TUDA-MUST/Multi-Ferro-DAQ/Blink/README.txt

This is a first example programm to test the programming of
the Schlaubi-Schlumpf board.
It intends to use the LEDs in a simple manner

It may be useful to label the boot and reset button on future iterations:
S2 -> booot -> inner button
S3 -> reset -> outer button

Blink is deprecated due to timing, Blink2 is the current version
