TUDA-MUST/Multi-Ferro-DAQ/Software/ADC_readout/deprecated/notes.txt

bbb131E08: 
	ist für BeagleBone PRU in ARM Assembly geschrieben -> ungeeignet
ads131e08:
	ist für stm32 in c geschrieben, muss auf andere HW umgeschrieben werden
