TUDA-MUST/Multi-Ferro-DAQ/Migration_from_MATLAB/C_GUI_Host/hqdefault-2535131512.jpg

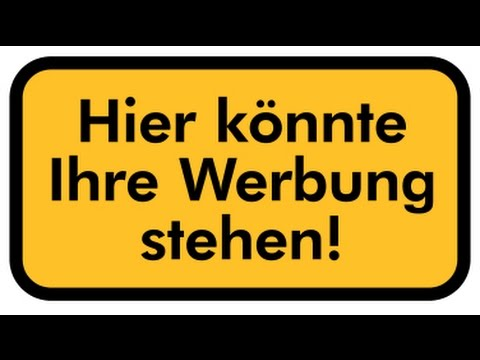
Migration_from_MATLAB/C_GUI_Host/hqdefault-2535131512.jpg
