TUDA-MUST/Multi-Ferro-DAQ/PCB/Schlaubi-Schlumpf/aay7rrjnp.png

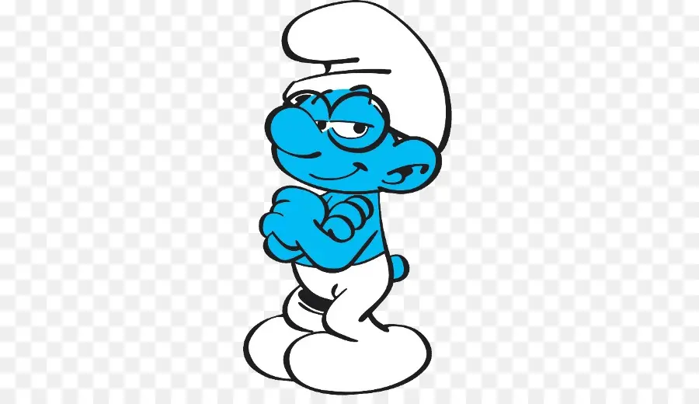
PCB/Schlaubi-Schlumpf/aay7rrjnp.png
