TUDA-MUST/Multi-Ferro-DAQ/PCB/BOM/BOM_Multi-Ferro-DAQ_v1.3.csv

Item | Qty | Designators | Value | Category | Manufacturer | MPN | Package | Specs | LCSC | Footprint | Datasheet | Notes
1 | 1 | IC1 | ADS131E08IPAGR | IC | Texas Instruments | ADS131E08IPAGR | TQFP-64 | 8-ch, 24-bit simultaneous-sampling ΔΣ ADC, up to 64 kSPS, SPI | C190276 | QFP50P1200X1200X120-64N | https://www.lcsc.com/datasheet/C190276.pdf
2 | 1 | IC2 | TP4056 | IC | TOP POWER ASIC | TP4056X-42-ESOP8 | ESOP-8 | 1-cell Li-ion linear charger, 4.2 V, ≤1 A | C2763448 | SOP127P600X175-9N | https://www.lcsc.com/datasheet/C2763448.pdf | No cell protection on board – use a protected 1S Li-ion/LiPo cell.
3 | 1 | IC3 | TLV9051IDBVR | IC | Texas Instruments | TLV9051IDBVR | SOT-23-5 | RRIO op-amp, 5 MHz, 1.8–6 V | C1849429 | SOT95P280X145-5N | https://www.lcsc.com/datasheet/C1849429.pdf | V_bias buffer
4 | 1 | IC5 | TPS7A9101DSKR | IC | Texas Instruments | TPS7A9101DSKR | WSON-10 2.5×2.5 | 1 A adjustable low-noise LDO, 4.7 µV_RMS | C2878140 | SON50P250X250X80-11N-D | https://www.lcsc.com/datasheet/C2878140.pdf
5 | 1 | IC7 | LM2775QDSGRQ1 | IC | Texas Instruments | LM2775QDSGRQ1 | WSON-8 2×2 | Switched-cap boost, 5 V out, 200 mA | C2071153 | SON50P200X200X80-9N | https://www.lcsc.com/datasheet/C2071153.pdf
6 | 2 | U1, U4 | AD8608ARUZ-REEL | IC | Analog Devices | AD8608ARUZ-REEL | TSSOP-14 | Quad CMOS RRIO op-amp, 2.7–5.5 V, 10 MHz GBW, 1 pA I_b, 75 µV V_os | C578777 | RU_14_ADI | https://www.lcsc.com/datasheet/C578777.pdf | Charge amplifiers, 2 × 4 channels
7 | 1 | U3 | ICM-42670-P | IC | TDK InvenSense | ICM-42670-P | LGA-14 2.5×3 mm | 6-axis IMU, I²C/SPI/I3C | C3288646 | LGA14_2.5X3X0.76_IVS | https://www.lcsc.com/datasheet/C3288646.pdf | Populated but not used by current firmware
8 | 1 | U2 | ESP32-S3-MINI-1-N8 | Module | Espressif | ESP32-S3-MINI-1-N8 | SMD module | ESP32-S3, 8 MB flash, Wi-Fi/BLE 5, PCB antenna | C2913206 | XCVR_ESP32-S3-MINI-1-N8 | https://www.lcsc.com/datasheet/C2913206.pdf
9 | 1 | Q1 | DMG2305 | Transistor | TECH PUBLIC | DMG2305UX | SOT-23 | P-MOSFET, −20 V, 4.1 A, 52 mΩ @ 4.5 V | C2940629 | DMG2305UX | https://www.lcsc.com/datasheet/C2940629.pdf | LCSC part is a second-source of the Diodes Inc. DMG2305UX
10 | 1 | D1 | D_Schottky | Diode | R+O | BAT60B | SOD-323 | Schottky, 10 V, 3 A, 0.6 V @ 1 A | C7502695 | D_SOD-323 | https://www.lcsc.com/datasheet/C7502695.pdf
11 | 1 | U5 | WE-TVS-82400102 | Diode | Würth Elektronik | 82400102 | SOT-23-6 | 2-ch low-capacitance TVS array (WE-TVS), USB | C1975330 | SOT-23-6 | https://uk.farnell.com/wurth-elektronik/82400102/diode-tvs-2-ch-esd-usb1-2-s0t23/dp/1825875 | USB ESD protection
12 | 2 | D2, D3 | LED_R | LED | Hubei KENTO | KT-0603R | 0603 | Red, 615–630 nm | C2286 | LED_0603_1608Metric | https://www.lcsc.com/datasheet/C2286.pdf
13 | 1 | D4 | LED_W | LED | Hubei KENTO | KT-0603W | 0603 | White | C2290 | LED_0603_1608Metric | https://www.lcsc.com/datasheet/C2290.pdf | Under RF shield, flashes when ADC is configured
14 | 2 | D5, D6 | SK6812MINI-HS | LED | OPSCO | SK6812MINI-HS | 3.5×3.5 mm | Addressable RGB LED, 5 V | C2922787 | SK6812MNI-HS | https://www.lcsc.com/datasheet/C2922787.pdf | Status LEDs
15 | 7 | R1, R12, R13, R15, R16, R17, R2 | 10k | Resistor | UNI-ROYAL | 0603WAF1002T5E | 0603 | 10 kΩ ±1 %, 100 mW, thick film | C25804 | R_0603_1608Metric | https://www.lcsc.com/datasheet/C25804.pdf
16 | 2 | R19, R20 | 5.1k | Resistor | UNI-ROYAL | 0603WAF5101T5E | 0603 | 5.1 kΩ ±1 %, 100 mW, thick film | C23186 | R_0603_1608Metric | https://www.lcsc.com/datasheet/C23186.pdf | USB-C CC pull-downs
17 | 1 | R27 | 27R | Resistor | UNI-ROYAL | 0603WAF270JT5E | 0603 | 27 Ω ±1 %, 100 mW, thick film | C25190 | R_0603_1608Metric | https://www.lcsc.com/datasheet/C25190.pdf
18 | 4 | R28, R29, R30, Rf_Op1 | 0R | Resistor | UNI-ROYAL | 0603WAF0000T5E | 0603 | 0 Ω jumper, 100 mW | C21189 | R_0603_1608Metric | https://www.lcsc.com/datasheet/C21189.pdf
19 | 3 | R3, R4, R5 | 100R | Resistor | UNI-ROYAL | 0603WAF1000T5E | 0603 | 100 Ω ±1 %, 100 mW, thick film | C22775 | R_0603_1608Metric | https://www.lcsc.com/datasheet/C22775.pdf
20 | 1 | R32 | 1.15k | Resistor | YAGEO | RT0603BRE071K15L | 0603 | 1.15 kΩ ±0.1 %, 100 mW, ±50 ppm/K, thin film | C861724 | R_0603_1608Metric | https://www.lcsc.com/datasheet/C861724.pdf | LDO feedback divider (bottom). DVDD = 0.8 V × (1 + R33/R32) ≈ 3.28 V. Keep 0.1 % thin film.
21 | 2 | R33, R7 | 3.57k | Resistor | YAGEO | RT0603BRE073K57L | 0603 | 3.57 kΩ ±0.1 %, 100 mW, ±50 ppm/K, thin film | C326745 | R_0603_1608Metric | https://www.lcsc.com/datasheet/C326745.pdf | R33: LDO feedback divider (top), keep 0.1 % thin film. R7: TP4056 PROG resistor, I_chg ≈ 1200 V / 3.57 kΩ ≈ 336 mA (any 1 % part is fine here).
22 | 1 | R6 | 1k | Resistor | UNI-ROYAL | 0603WAF1001T5E | 0603 | 1 kΩ ±1 %, 100 mW, thick film | C21190 | R_0603_1608Metric | https://www.lcsc.com/datasheet/C21190.pdf
23 | 8 | RF1, RF2, RF3, RF4, RF5, RF6, RF7, RF8 | 1G | Resistor | Stackpole (SEI) | HVCB0805KDL1G00 | 0805 | 1 GΩ ±10 %, 200 mW, 600 V, ±200 ppm/K, thick film | C2484710 | R_0805_2012Metric_Pad1.20x1.40mm_HandSolder | https://www.lcsc.com/datasheet/C2484710.pdf | CRITICAL – charge-amp feedback resistor R_F. Sets τ = R_F·C_F = 0.68 s and the low-frequency corner; ±10 % tolerance applies directly to τ. Hand-solder footprint.
24 | 16 | C1, C8, C9, CS11, CS16, CS18, CS2, CS31, CS34, CS39, CS40, CS41, CS42, CS50, CS52, CS9 | 10u | Capacitor | Samsung Electro-Mechanics | CL10A106KP8NNNC | 0603 | 10 µF ±10 %, 10 V, X5R | C19702 | C_0603_1608Metric | https://www.lcsc.com/datasheet/C19702.pdf
25 | 11 | CCH1, CS10, CS12, CS13, CS14, CS4, CS47, CS48, CS5, CS7, CS8 | 1u | Capacitor | Samsung Electro-Mechanics | CL10A105KB8NNNC | 0603 | 1 µF ±10 %, 50 V, X5R | C15849 | C_0603_1608Metric | https://www.lcsc.com/datasheet/C15849.pdf
26 | 8 | CF1, CF2, CF3, CF4, CF5, CF6, CF7, CF8 | 680p | Capacitor | FH (Fenghua) | 0805CG681J500NT | 0805 | 680 pF ±5 %, 50 V, C0G/NP0 | C1835 | C_0805_2012Metric_Pad1.18x1.45mm_HandSolder | https://www.lcsc.com/datasheet/C1835.pdf | CRITICAL – charge-amp feedback capacitor C_F; sets gain ≈ 1/C_F. Must be C0G/NP0; do not substitute X7R. Hand-solder footprint.
27 | 14 | CS1, CS15, CS17, CS19, CS29, CS3, CS32, CS37, CS38, CS43, CS44, CS46, CS51, CS53 | 100n | Capacitor | YAGEO | CC0603KRX7R9BB104 | 0603 | 100 nF ±10 %, 50 V, X7R | C14663 | C_0603_1608Metric | https://www.lcsc.com/datasheet/C14663.pdf
28 | 1 | CS21 | 680n | Capacitor | CCTC | TCC0603X7R684K500CT | 0603 | 680 nF ±10 %, 50 V, X7R | C5360852 | C_0603_1608Metric | https://www.lcsc.com/datasheet/C5360852.pdf
29 | 3 | CS28, CS30, CS6 | 22u | Capacitor | Samsung Electro-Mechanics | CL10A226MQ8NRNC | 0603 | 22 µF ±20 %, 6.3 V, X5R | C59461 | C_0603_1608Metric | https://www.lcsc.com/datasheet/C59461.pdf
30 | 2 | CS33, CS49 | 10n | Capacitor | FH (Fenghua) | 0603B103K500NT | 0603 | 10 nF ±10 %, 50 V, X7R | C57112 | C_0603_1608Metric | https://www.lcsc.com/datasheet/C57112.pdf
31 | 2 | FB1, FB2 | FerriteBead | Inductor | Würth Elektronik | 742792641 | 0603 | Ferrite bead, 300 Ω @ 100 MHz, 2 A, 150 mΩ | C2649308 | L_0603_1608Metric | https://fat.lcsc.com/product-detail/Ferrite-Beads_Wurth-Elektronik-742792641_C2649308.html
32 | 1 | L1 | Choke_Wurth_WE-CNSW_744232090 | Inductor | Würth Elektronik | 744232090 | 1206 (WE-CNSW) | Common-mode choke, 90 Ω @ 100 MHz, 370 mA, USB 2.0 | C2649327 | L_CommonMode_Wurth_WE-CNSW-1206 | https://www.digikey.co.uk/en/products/detail/w%C3%BCrth-elektronik/744232090/1638873 | USB data lines
33 | 2 | GPIO1, GPIO2 | Conn_01x02_Pin | Connector | XFCN | PZ254V-11-02P | THT, 2.54 mm | 1×2 pin header | C492401 | PinHeader_1x02_P2.54mm_Vertical | https://www.lcsc.com/datasheet/C492401.pdf
34 | 2 | J1, J5 | 8P8C_Shielded | Connector | CKMTW | R-RJ45R08P-B000 | THT, right angle | RJ45 8P8C, shielded, no LEDs, no magnetics | C386756 | R-RJ45R08P-B000 | https://www.lcsc.com/datasheet/C386756.pdf | Sensor inputs, 4 channels per port (T-568B pinout on silkscreen)
35 | 2 | J2, J3 | Conn_01x04_Socket | Connector | JST | BM04B-SRSS-TBT(LF)(SN) | SMD, 1.0 mm | SH 1×4 header, vertical | C495539 | JST_SH_BM04B-SRSS-TB_1x04-1MP_P1.00mm_Vertical | https://www.lcsc.com/datasheet/C495539.pdf
36 | 1 | J4 | Conn_01x02_Pin | Connector | JST | B2B-PH-K-E(LF)(SN) | THT, 2.0 mm | PH 1×2 header | C594142 | JST_PH_B2B-PH-K_1x02_P2.00mm_Vertical | https://www.lcsc.com/datasheet/C594142.pdf | Battery connector
37 | 1 | J6 | TYPE-C-31-M-12 | Connector | Korean Hroparts (HRO) | TYPE-C-31-M-12 | SMD | USB Type-C receptacle, 16 pin | C165948 | HRO_TYPE-C-31-M-12 | https://www.lcsc.com/datasheet/C165948.pdf
38 | 1 | S1 | SK-12D02-VG3 | Switch | Korean Hroparts (HRO) | SK-12D02-VG3 | THT, right angle | SPDT slide switch | C136723 | SK12D02VG3 | https://www.lcsc.com/datasheet/C136723.pdf | Power switch
39 | 2 | S2, S3 | SKRPABE010 | Switch | ALPS ALPINE | SKRPABE010 | SMD 4.2×3.2 mm | Tactile switch, SPST-NO | C115360 | SW_SKRPABE010 | https://www.lcsc.com/datasheet/C115360.pdf | BOOT / RESET
40 | 1 | H2 | MountingHole_Pad | Mechanical | YIYUAN | SMTSOM330BTR | SMT standoff | M3 threaded SMT standoff, tin-plated copper | C5221843 | MountingHole_3.2mm_M3_Pad | https://www.lcsc.com/datasheet/C5221843.pdf
41 | 1 | J7 | RFShield_TwoPieces | Mechanical | Laird | BMI-S-204-F | SMD, 32 × 32 mm | Two-piece board-level RF shield – frame (soldered) | C5241024 | Laird_Technologies_BMI-S-204-F_32.00x32.00mm | https://azcus.digikey.com/en/products/detail/laird-technologies-emi/BMI-S-204-F/2175891 | Frame only. Order the matching cover BMI-S-204-C separately and snap it on after assembly (see "Hand-fitted after assembly").
42 | 1 | J7 (cover) | RF shield cover | Mechanical (hand-fitted) | Laird | BMI-S-204-C | 32 × 32 mm | Snap-on cover for BMI-S-204-F frame |  |  |  | Not part of the JLCPCB assembly – order separately and press onto the J7 frame after assembly.
