TUDA-MUST/Multi-Ferro-DAQ/PCB/components/LTC6820IMS/LTC6820IMS#3ZZPBF.stp

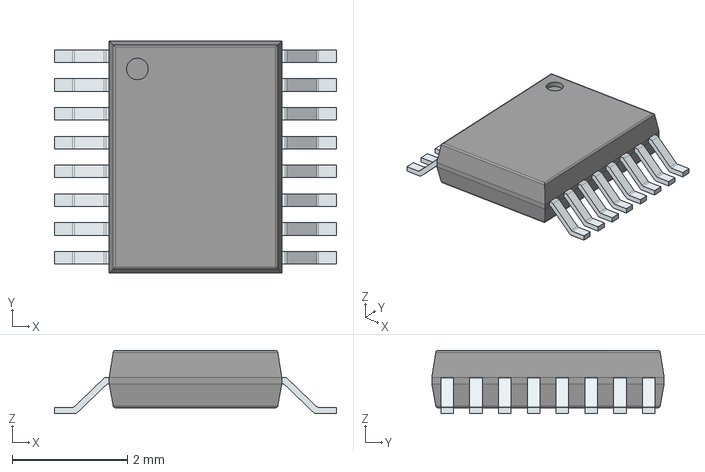
[picture p5: CAD file, 2025-12-17]
PCB/components/LTC6820IMS/LTC6820IMS#3ZZPBF.stp
4.90 x 4.04 x 1.10 mm
PinsArrayLR
