TUDA-MUST/Multi-Ferro-DAQ/PCB/components/PE-68386NL/PE-68386NL.stp

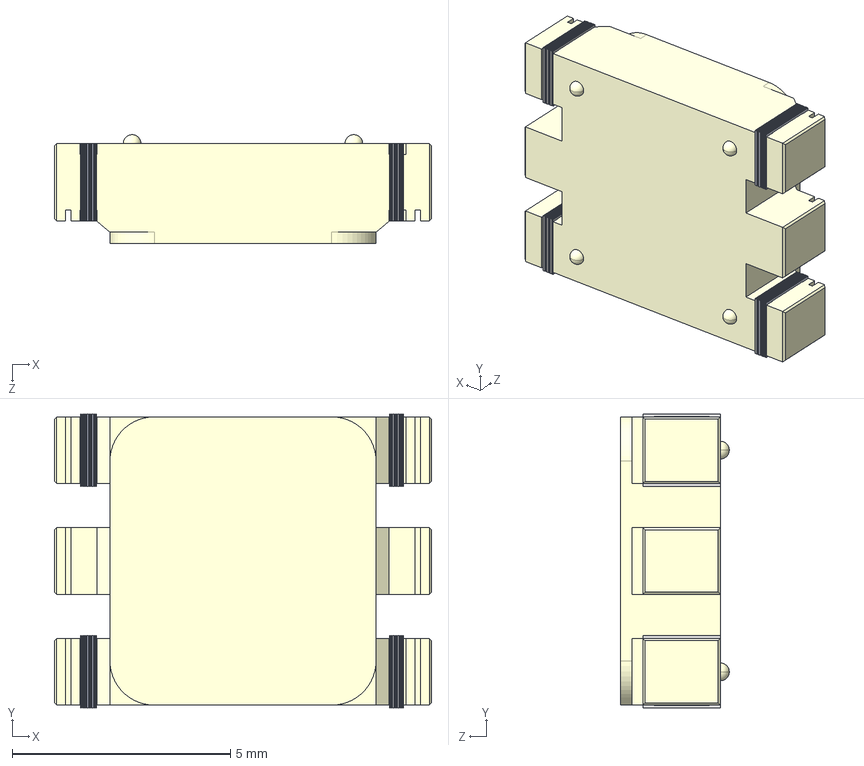
[picture p6: CAD file, 2025-12-17]
PCB/components/PE-68386NL/PE-68386NL.stp
8.64 x 6.73 x 2.49 mm
