TUDA-MUST/Multi-Ferro-DAQ/PCB/Multi-Ferro-DAQ.step

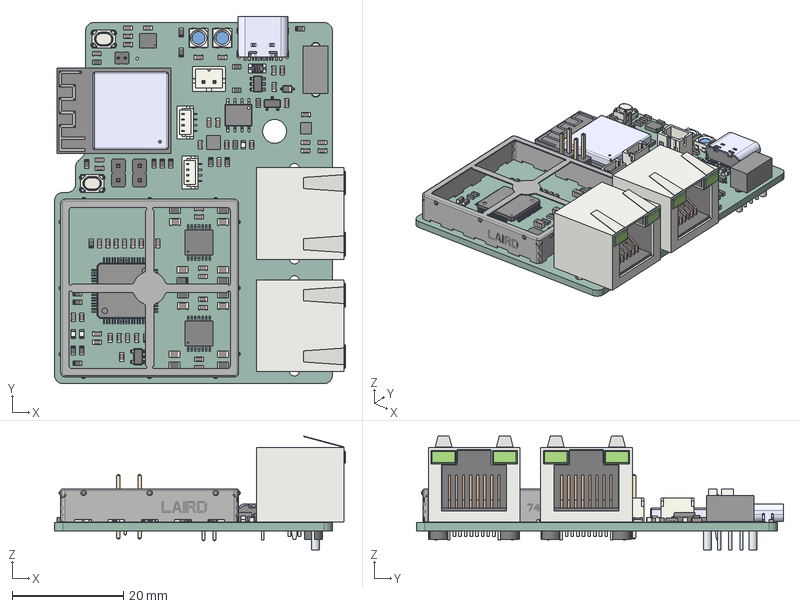
[picture p7: CAD file, 2026-11-03]
PCB/Multi-Ferro-DAQ.step
52.4 x 66.1 x 20.5 mm
R_0603_1608Metric x 21
R_0805_2012Metric x 8
SOT-23-6
C_0805_2012Metric x 8
C_0603_1608Metric x 47
JST_SH_BM04B-SRSS-TB_1x04-1MP_P1.00mm_Vertical x 2
JST_B2B_PH_K
PinHeader_1x02_P127mm_Vertical
RJ45_Amphenol_RJHSE538X x 2
Geh㴳e
Boden
Lötfläche x 4
LED_0603_1608Metric x 3
PinHeader_1x02_P254mm_Vertical x 2
LED_WS2812B-Mini_PLCC4_3.5x3.5mm_P1.8mm x 2
ESP32-S3-MINI-1-N8
L_0603_1608Metric x 2
BODY-SON x 2
FRAME-DSK0010A
PIN1-ID x 2
BMI-S-204-F
SOT-23
SKRPAB x 2
TYPE-C-31-M-12
SOT-23-5
D_SOD-323
BODY_VEC64A
LEAD_VEC64A x 64
Leads x 5
TP4056
Multi-Ferro-DAQ_PCB
