TUDA-MUST/Multi-Ferro-DAQ/PCB/Schlaubi-Schlumpf/components/ICM-42670-P/LGA14_2_5X3X0_76_IVS.step

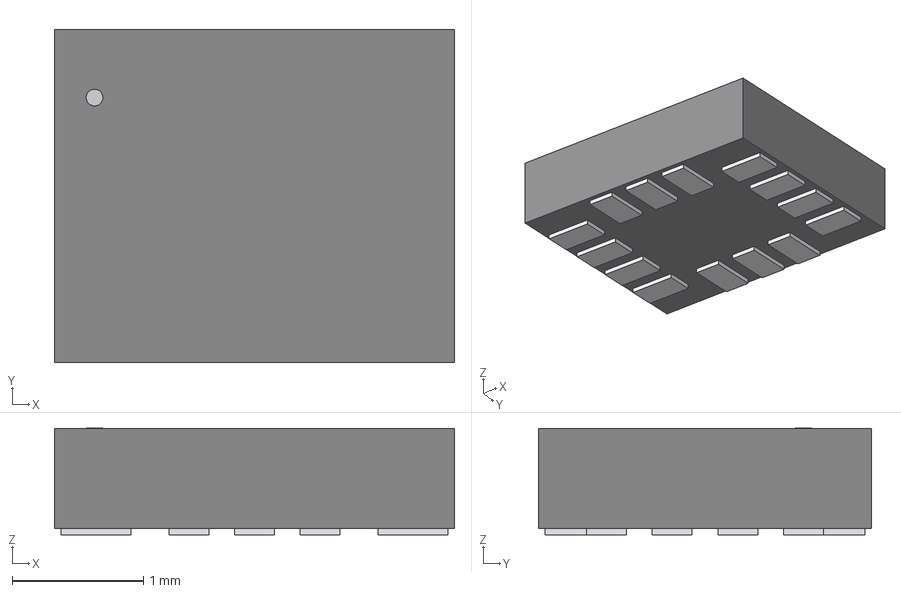
[picture p8: CAD file, 2024-10-23]
PCB/Schlaubi-Schlumpf/components/ICM-42670-P/LGA14_2_5X3X0_76_IVS.step
3.05 x 2.54 x 0.815 mm
