TUDA-MUST/Multi-Ferro-DAQ/PCB/Schlaubi-Schlumpf.step

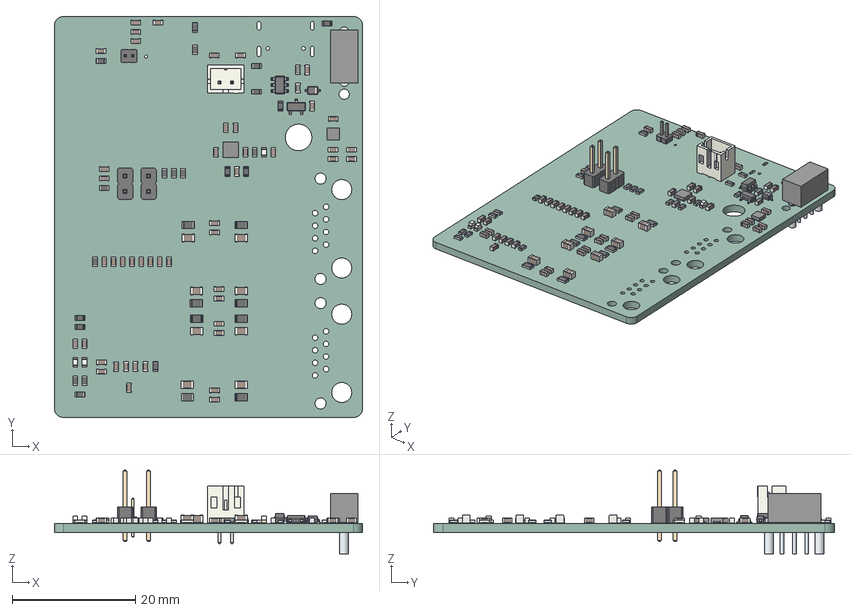
[picture p9: CAD file, 2026-01-19]
PCB/Schlaubi-Schlumpf.step
50.0 x 65.0 x 13.5 mm
R_0603_1608Metric x 21
R_0805_2012Metric x 8
SOT-23-6
C_0805_2012Metric x 8
C_0603_1608Metric x 47
JST_PH_B2B-PH-K_1x02_P2.00mm_Vertical
PinHeader_1x02_P1.27mm_Vertical
LED_0603_1608Metric x 3
PinHeader_1x02_P2.54mm_Vertical x 2
L_0603_1608Metric x 2
BODY-SON x 2
FRAME-DSK0010A
PIN1-ID x 2
SOT-23
D_SOD-323
Leads x 5
Schlaubi-Schlumpf_PCB
