TUDA-MUST/Multi-Ferro-DAQ/MMM/TODO.md

# TODO for migrating Multi-ferro-DAQ away from MATLAB

## rewriting MATLAB to C

- hosting WiFi
- supporting multiple DAQs
- support syncing ESP
- support GUI

    - save .csv
    - organize measurement
---

## rewriting DAQ ESP

- migrate to client
- migrate to multiple clients
- hardcode client ID -> don't mix up DAQs

---

## writing syncing ESP

- integrate as a client for time syncing to treadmill

---
