TUDA-MUST/Multi-Ferro-DAQ/PCB/Multi-Ferro-DAQ.kicad_pcb

## KiCad design PCB/Multi-Ferro-DAQ.kicad_pcb (2026-11-14)

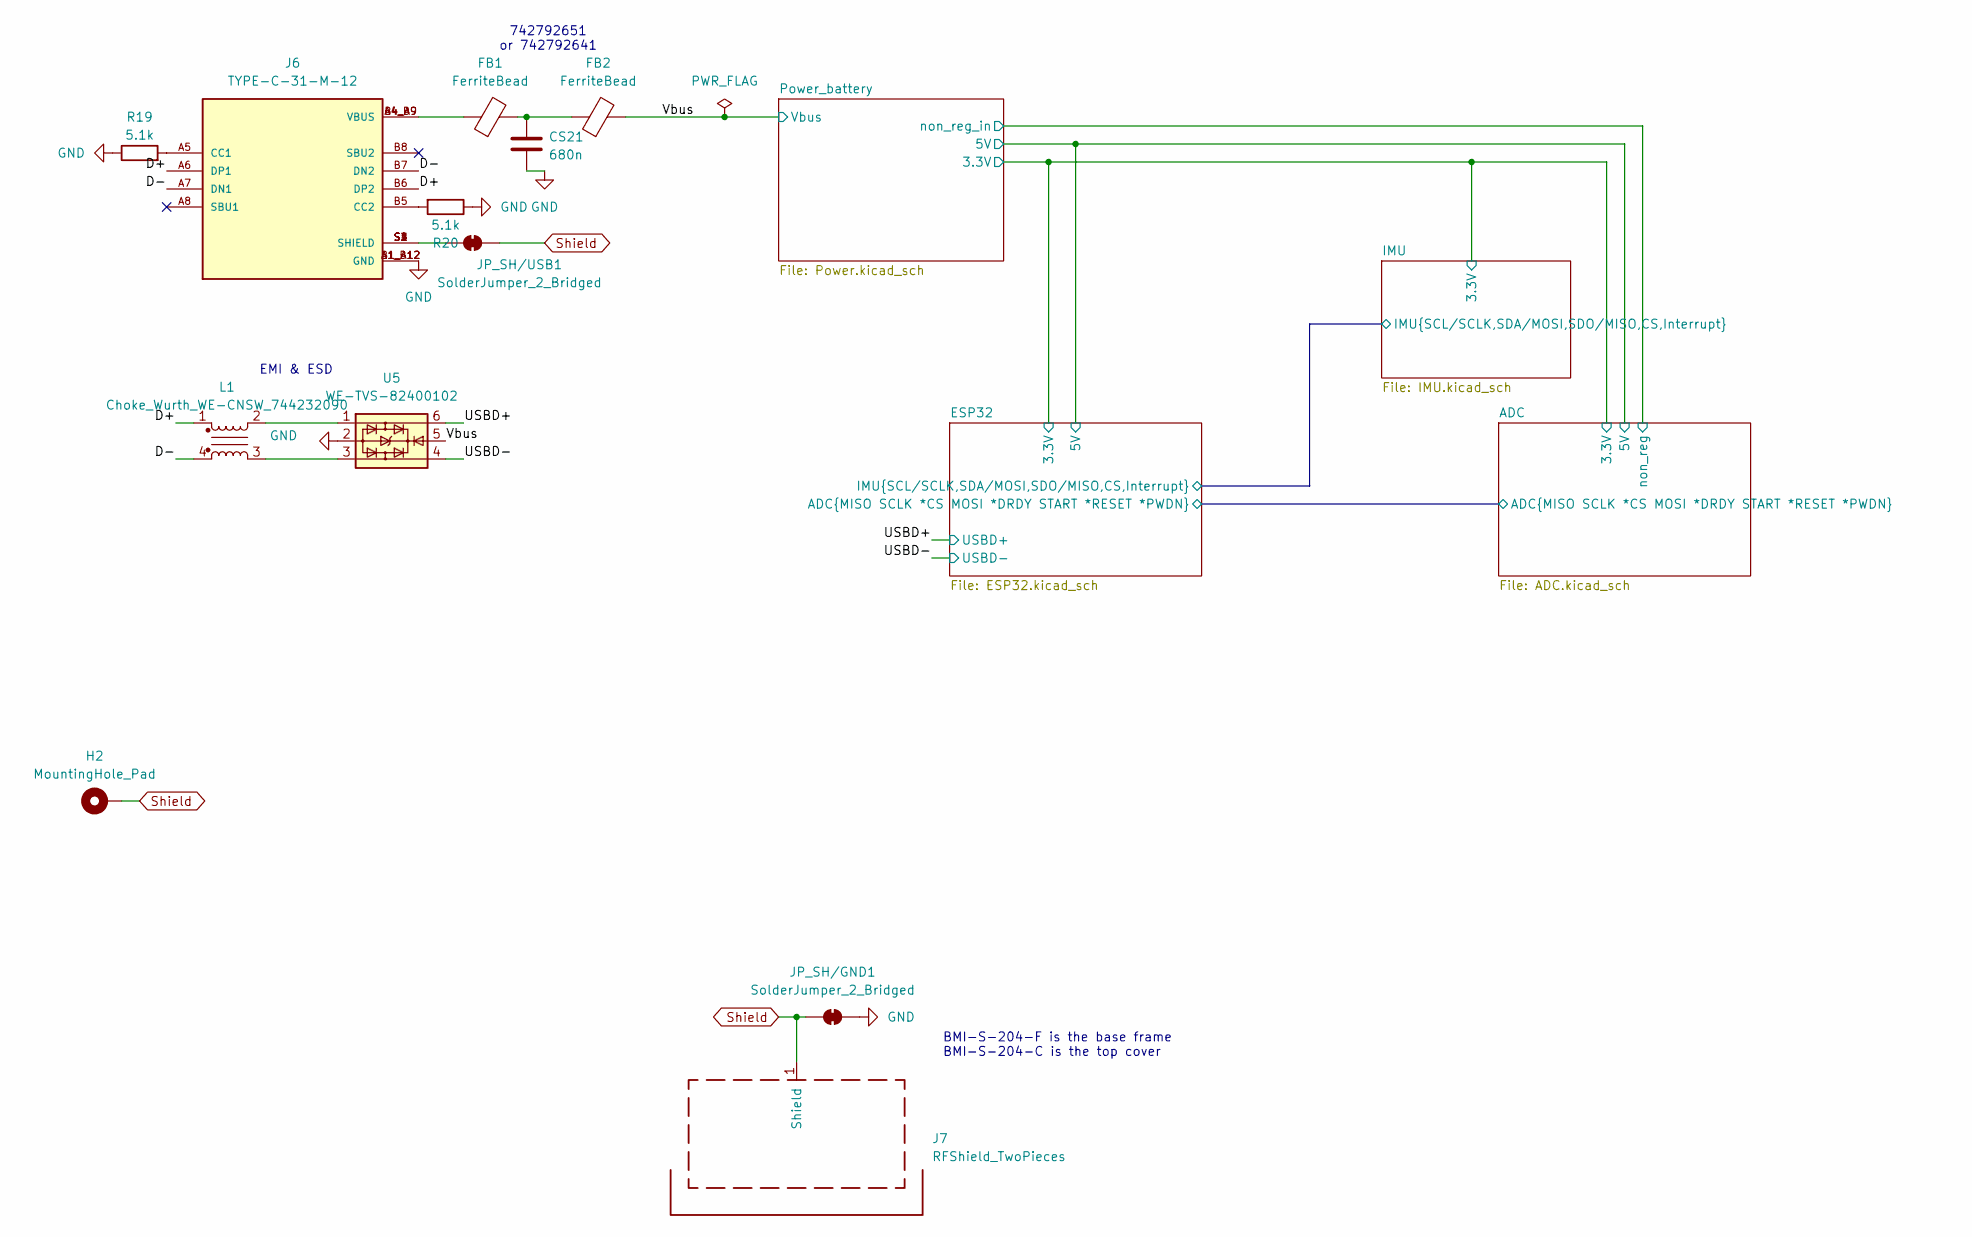
[picture p10: schematic Multi-Ferro-DAQ.kicad_sch]

Parts:
CS21: 680n; C_0603_1608Metric; LCSC C5360852
FB1, FB2: FerriteBead; L_0603_1608Metric; LCSC C2649308
H2: MountingHole_Pad; MountingHole_3.2mm_M3_Pad; LCSC C5221843
J6: TYPE-C-31-M-12; HRO_TYPE-C-31-M-12; PARTREV 2020.12.08; LCSC C165948
J7: RFShield_TwoPieces; Laird_Technologies_BMI-S-204-F_32.00x32.00mm; LCSC C5241024
JP_SH/GND1: SolderJumper_2_Bridged; SolderJumper-2_P1.3mm_Bridged2Bar_RoundedPad1.0x1.5mm
JP_SH/USB1: SolderJumper_2_Bridged; SolderJumper-2_P1.3mm_Bridged2Bar_RoundedPad1.0x1.5mm
L1: Choke_Wurth_WE-CNSW_744232090; L_CommonMode_Wurth_WE-CNSW-1206; LCSC C2649327
R19, R20: 5.1k; R_0603_1608Metric; LCSC C23186
U5: WE-TVS-82400102; SOT-23-6; LCSC C1975330

Connections:
/D+: J6.A6 (DP1), J6.B6 (DP2), L1.1
/D-: J6.A7 (DN1), J6.B7 (DN2), L1.4
/USBD+: U5.6; also elsewhere on the board
/USBD-: U5.4; also elsewhere on the board
/Vbus: FB2.2, U5.5; also elsewhere on the board
GND: CS21.1, J6.A1_B12 (GND), J6.B1_A12 (GND), JP_SH/GND1.2 (B), R19.1, R20.1, U5.2; also elsewhere on the board
unnamed: CS21.2, FB1.2, FB2.1
unnamed: FB1.1, J6.A4_B9 (VBUS), J6.B4_A9 (VBUS)
unnamed: J6.A5 (CC1), R19.2
unnamed: J6.B5 (CC2), R20.2
unnamed: J6.S1 (SHIELD), J6.S2 (SHIELD), J6.S3 (SHIELD), J6.S4 (SHIELD), JP_SH/USB1.1 (A)
unnamed: L1.2, U5.1
unnamed: L1.3, U5.3
Shield: H2.1 (1_1), J7.1 (Shield_1), JP_SH/GND1.1 (A), JP_SH/USB1.2 (B); also elsewhere on the board

Notes on the sheet:
BMI-S-204-F is the base frame BMI-S-204-C is the top cover
742792651 or 742792641
EMI & ESD

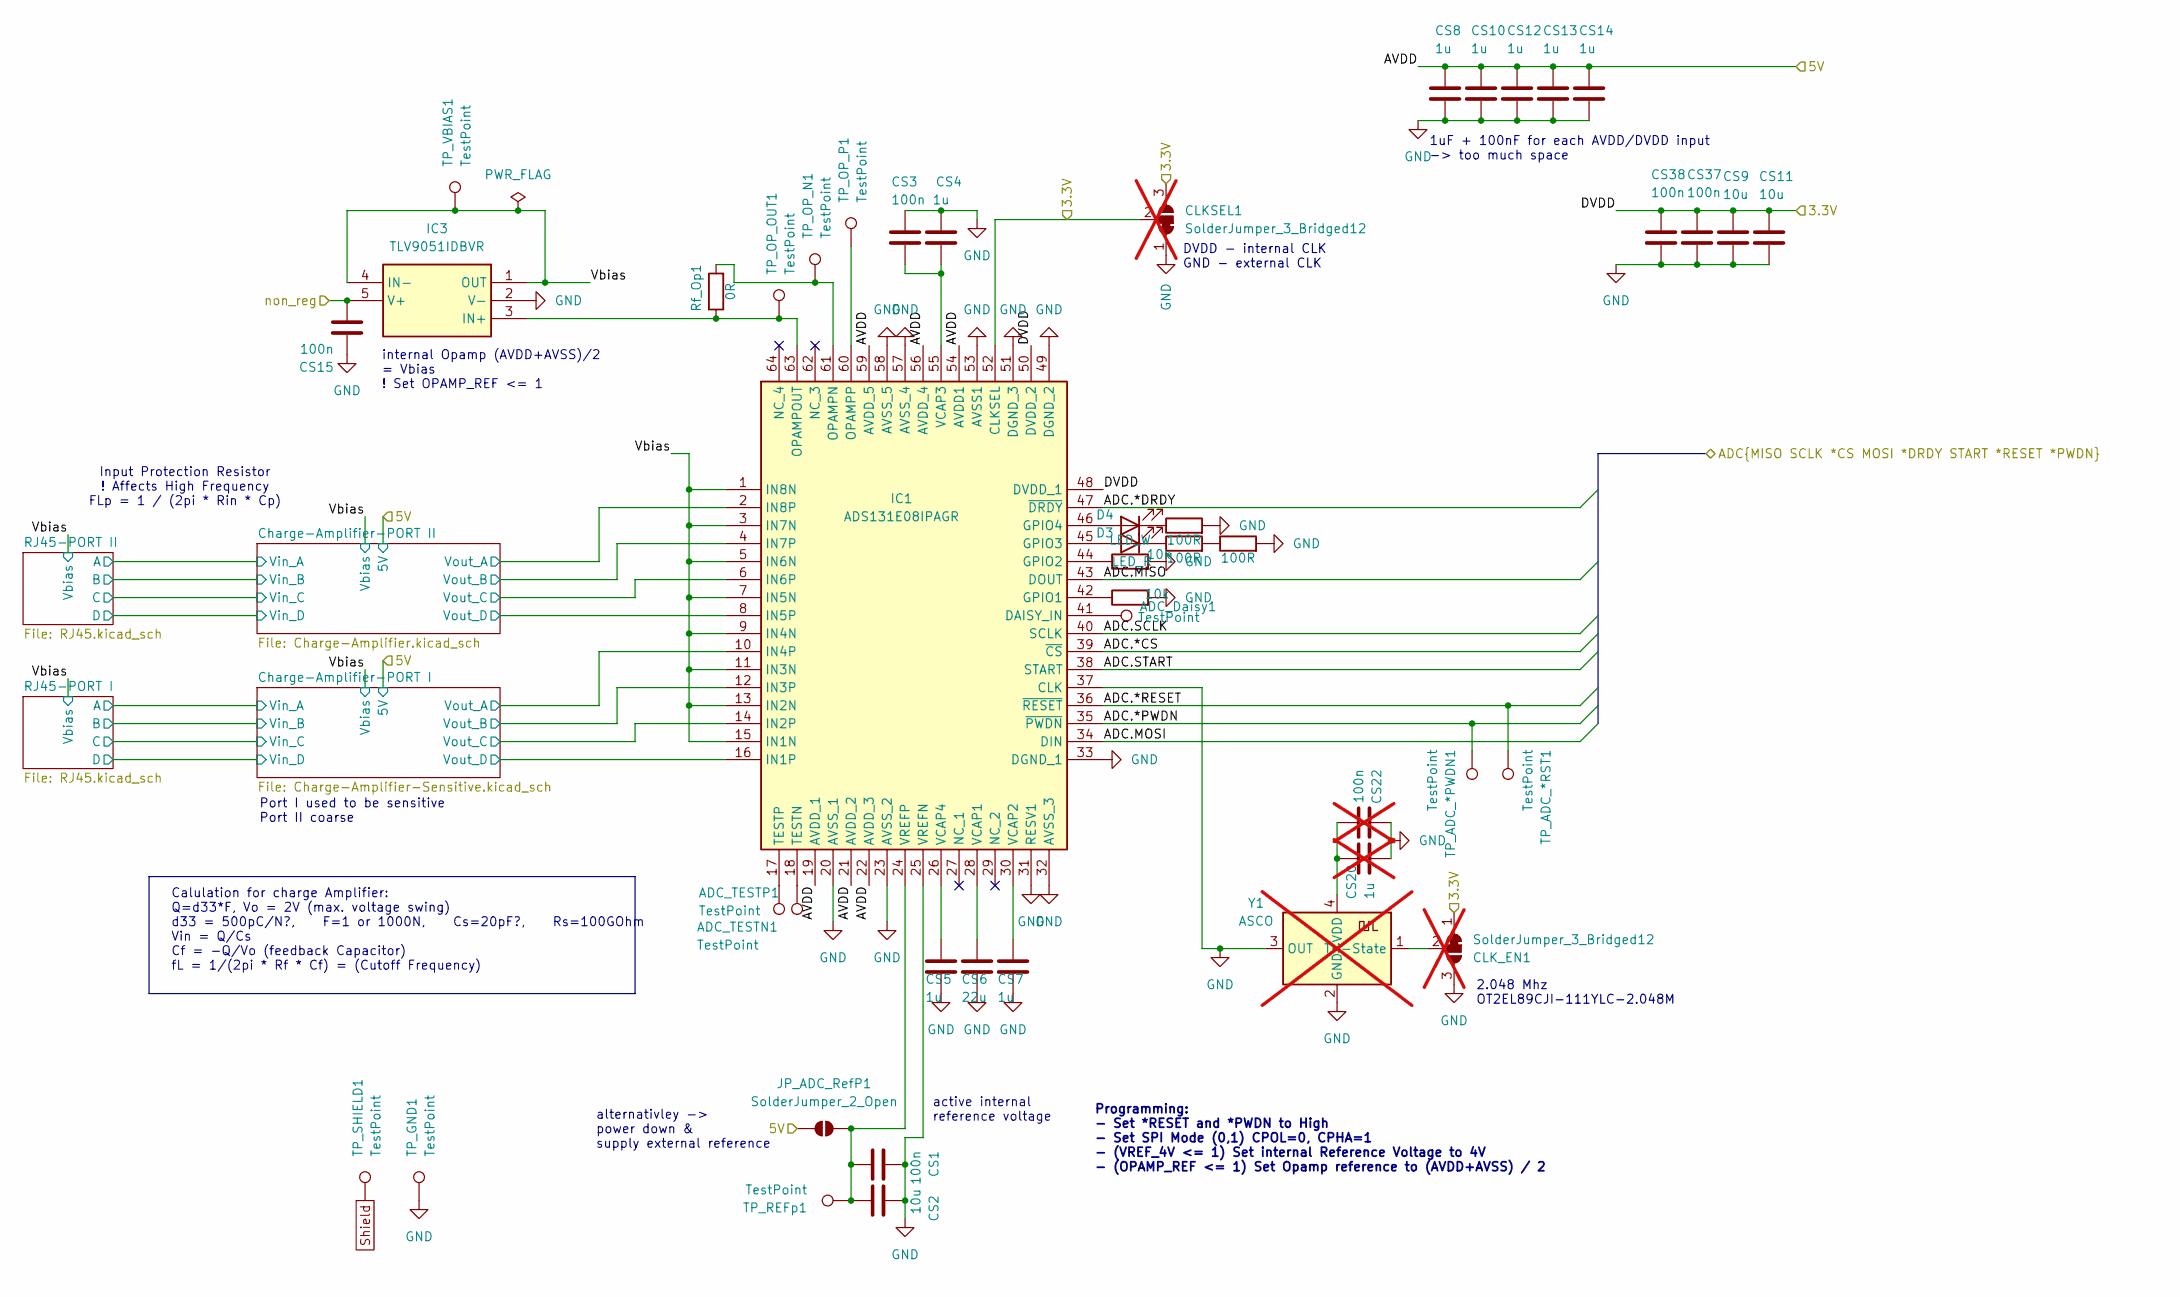
[picture p11: schematic ADC.kicad_sch]

Parts:
ADC_Daisy1: TestPoint; TestPoint_Pad_D1.0mm
ADC_TESTN1: TestPoint; TestPoint_Pad_D1.0mm
ADC_TESTP1: TestPoint; TestPoint_Pad_D1.0mm
CLKSEL1: SolderJumper_3_Bridged12; SolderJumper-3_P1.3mm_Bridged2Bar12_RoundedPad1.0x1.5mm; not fitted
CLK_EN1: SolderJumper_3_Bridged12; SolderJumper-3_P1.3mm_Bridged2Bar12_RoundedPad1.0x1.5mm; not fitted
CS1, CS3, CS15, CS37, CS38: 100n; C_0603_1608Metric; LCSC C14663
CS2, CS9, CS11: 10u; C_0603_1608Metric; LCSC C19702
CS4, CS5, CS7, CS8, CS10, CS12, CS13, CS14: 1u; C_0603_1608Metric; LCSC C15849
CS6: 22u; C_0603_1608Metric; LCSC C59461
CS20: 1u; C_0603_1608Metric; not fitted
CS22: 100n; C_0603_1608Metric; not fitted
D3: LED_R; LED_0603_1608Metric; LCSC C2286
D4: LED_W; LED_0603_1608Metric; LCSC C2290
IC1: ADS131E08IPAGR; QFP50P1200X1200X120-64N; Mouser Part Number 595-ADS131E08IPAGR
IC3: TLV9051IDBVR; SOT95P280X145-5N; Mouser Part Number 595-TLV9051IDBVR
JP_ADC_RefP1: SolderJumper_2_Open; SolderJumper-2_P1.3mm_Open_RoundedPad1.0x1.5mm
R1, R2: 10k; R_0603_1608Metric; LCSC C25804
R3, R4, R5: 100R; R_0603_1608Metric; LCSC C22775
Rf_Op1: 0R; R_0603_1608Metric; LCSC C21189
TP_ADC_*PWDN1: TestPoint; TestPoint_Pad_D1.0mm
TP_ADC_*RST1: TestPoint; TestPoint_Pad_D1.0mm
TP_GND1: TestPoint; TestPoint_Pad_D1.0mm
TP_OP_N1: TestPoint; TestPoint_Pad_D1.0mm
TP_OP_OUT1: TestPoint; TestPoint_Pad_D1.0mm
TP_OP_P1: TestPoint; TestPoint_Pad_D1.0mm
TP_REFp1: TestPoint; TestPoint_Pad_D1.0mm
TP_SHIELD1: TestPoint; TestPoint_Pad_D1.0mm
TP_VBIAS1: TestPoint; TestPoint_Pad_D1.0mm
Y1: ASCO; Crystal_SMD_3225-4Pin_3.2x2.5mm; not fitted

Connections:
/ADC/ADC.*CS: IC1.39 (~CS); also elsewhere on the board
/ADC/ADC.*DRDY: IC1.47 (~DRDY); also elsewhere on the board
/ADC/ADC.*PWDN: IC1.35 (~PWDN), TP_ADC_*PWDN1.1 (1_1); also elsewhere on the board
/ADC/ADC.*RESET: IC1.36 (~RESET), TP_ADC_*RST1.1 (1_1); also elsewhere on the board
/ADC/ADC.MISO: IC1.43 (DOUT); also elsewhere on the board
/ADC/ADC.MOSI: IC1.34 (DIN); also elsewhere on the board
/ADC/ADC.SCLK: IC1.40 (SCLK); also elsewhere on the board
/ADC/ADC.START: IC1.38 (START); also elsewhere on the board
/ADC/AVDD: CS8.2, CS10.2, CS12.2, CS13.2, CS14.2, IC1.19 (AVDD_1), IC1.21 (AVDD_2), IC1.22 (AVDD_3), IC1.54 (AVDD1), IC1.56 (AVDD_4), IC1.59 (AVDD_5), JP_ADC_RefP1.1 (A); also elsewhere on the board
/ADC/Charge-Amplifier-PORT I/Vout_A: IC1.10 (IN4P); also elsewhere on the board
/ADC/Charge-Amplifier-PORT I/Vout_B: IC1.12 (IN3P); also elsewhere on the board
/ADC/Charge-Amplifier-PORT I/Vout_C: IC1.14 (IN2P); also elsewhere on the board
/ADC/Charge-Amplifier-PORT I/Vout_D: IC1.16 (IN1P); also elsewhere on the board
/ADC/Charge-Amplifier-PORT II/Vout_A: IC1.2 (IN8P); also elsewhere on the board
/ADC/Charge-Amplifier-PORT II/Vout_B: IC1.4 (IN7P); also elsewhere on the board
/ADC/Charge-Amplifier-PORT II/Vout_C: IC1.6 (IN6P); also elsewhere on the board
/ADC/Charge-Amplifier-PORT II/Vout_D: IC1.8 (IN5P); also elsewhere on the board
/ADC/DVDD: CLKSEL1.2 (C), CLKSEL1.3 (B), CLK_EN1.1 (A), CS9.2, CS11.2, CS37.2, CS38.2, IC1.48 (DVDD_1), IC1.50 (DVDD_2), IC1.52 (CLKSEL); also elsewhere on the board
/ADC/Vbias: IC1.1 (IN8N), IC1.3 (IN7N), IC1.5 (IN6N), IC1.7 (IN5N), IC1.9 (IN4N), IC1.11 (IN3N), IC1.13 (IN2N), IC1.15 (IN1N), IC3.1 (OUT), IC3.4 (IN-), TP_VBIAS1.1 (1_1); also elsewhere on the board
/Power_battery/non_reg_in: CS15.1, IC3.5 (V+); also elsewhere on the board
GND: CLKSEL1.1 (A), CLK_EN1.3 (B), CS1.2, CS2.2, CS3.2, CS4.1, CS5.2, CS6.2, CS7.2, CS8.1, CS9.1, CS10.1, CS11.1, CS12.1, CS13.1, CS14.1, CS15.2, CS20.2, CS22.2, CS37.1, CS38.1, IC1.20 (AVSS_1), IC1.23 (AVSS_2), IC1.25 (VREFN), IC1.31 (RESV1), IC1.32 (AVSS_3), IC1.33 (DGND_1), IC1.37 (CLK), IC1.49 (DGND_2), IC1.51 (DGND_3), IC1.53 (AVSS1), IC1.57 (AVSS_4), IC1.58 (AVSS_5), IC3.2 (V-), R1.2, R2.2, R3.2, R5.2, TP_GND1.1 (1_1), Y1.2 (GND), Y1.3 (OUT); also elsewhere on the board
unnamed: CLK_EN1.2 (C), Y1.1 (Tri-State)
unnamed: CS20.1, CS22.1, Y1.4 (VDD)
unnamed: D3.2 (A), IC1.45 (GPIO3)
unnamed: D3.1 (K), R4.1
unnamed: D4.2 (A), IC1.46 (GPIO4)
unnamed: D4.1 (K), R3.1
unnamed: ADC_Daisy1.1 (1_1), IC1.41 (DAISY_IN)
unnamed: IC1.42 (GPIO1), R2.1
unnamed: IC1.44 (GPIO2), R1.1
unnamed: IC1.61 (OPAMPN), Rf_Op1.2, TP_OP_N1.1 (1_1)
unnamed: IC1.63 (OPAMPOUT), IC3.3 (IN+), Rf_Op1.1, TP_OP_OUT1.1 (1_1)
unnamed: IC1.60 (OPAMPP), TP_OP_P1.1 (1_1)
unnamed: ADC_TESTN1.1 (1_1), IC1.18 (TESTN)
unnamed: ADC_TESTP1.1 (1_1), IC1.17 (TESTP)
unnamed: CS6.1, IC1.28 (VCAP1)
unnamed: CS7.1, IC1.30 (VCAP2)
unnamed: CS3.1, CS4.2, IC1.55 (VCAP3)
unnamed: CS5.1, IC1.26 (VCAP4)
unnamed: CS1.1, CS2.1, IC1.24 (VREFP), JP_ADC_RefP1.2 (B), TP_REFp1.1 (1_1)
unnamed: R4.2, R5.1
Shield: TP_SHIELD1.1 (1_1); also elsewhere on the board

Notes on the sheet:
active internal reference voltage
Input Protection Resistor ! Affects High Frequency FLp = 1 / (2pi * Rin * Cp)
1uF + 100nF for each AVDD/DVDD input -> too much space
DVDD - internal CLK GND - external CLK
alternativley -> power down & supply external reference
2.048 Mhz OT2EL89CJI-111YLC-2.048M
Calulation for charge Amplifier: Q=d33*F, Vo = 2V (max. voltage swing) d33 = 500pC/N?, F=1 or 1000N, Cs=20pF?, Rs=100GOhm Vin = Q/Cs Cf = -Q/Vo (feedback Capacitor) fL = 1/(2pi * Rf * Cf) = (Cutoff Frequency)
Programming: - Set *RESET and *PWDN to High - Set SPI Mode (0,1) CPOL=0, CPHA=1 - (VREF_4V <= 1) Set internal Reference Voltage to 4V - (OPAMP_REF <= 1) Set Opamp reference to (AVDD+AVSS) / 2
internal Opamp (AVDD+AVSS)/2 = Vbias ! Set OPAMP_REF <= 1
Port I used to be sensitive Port II coarse

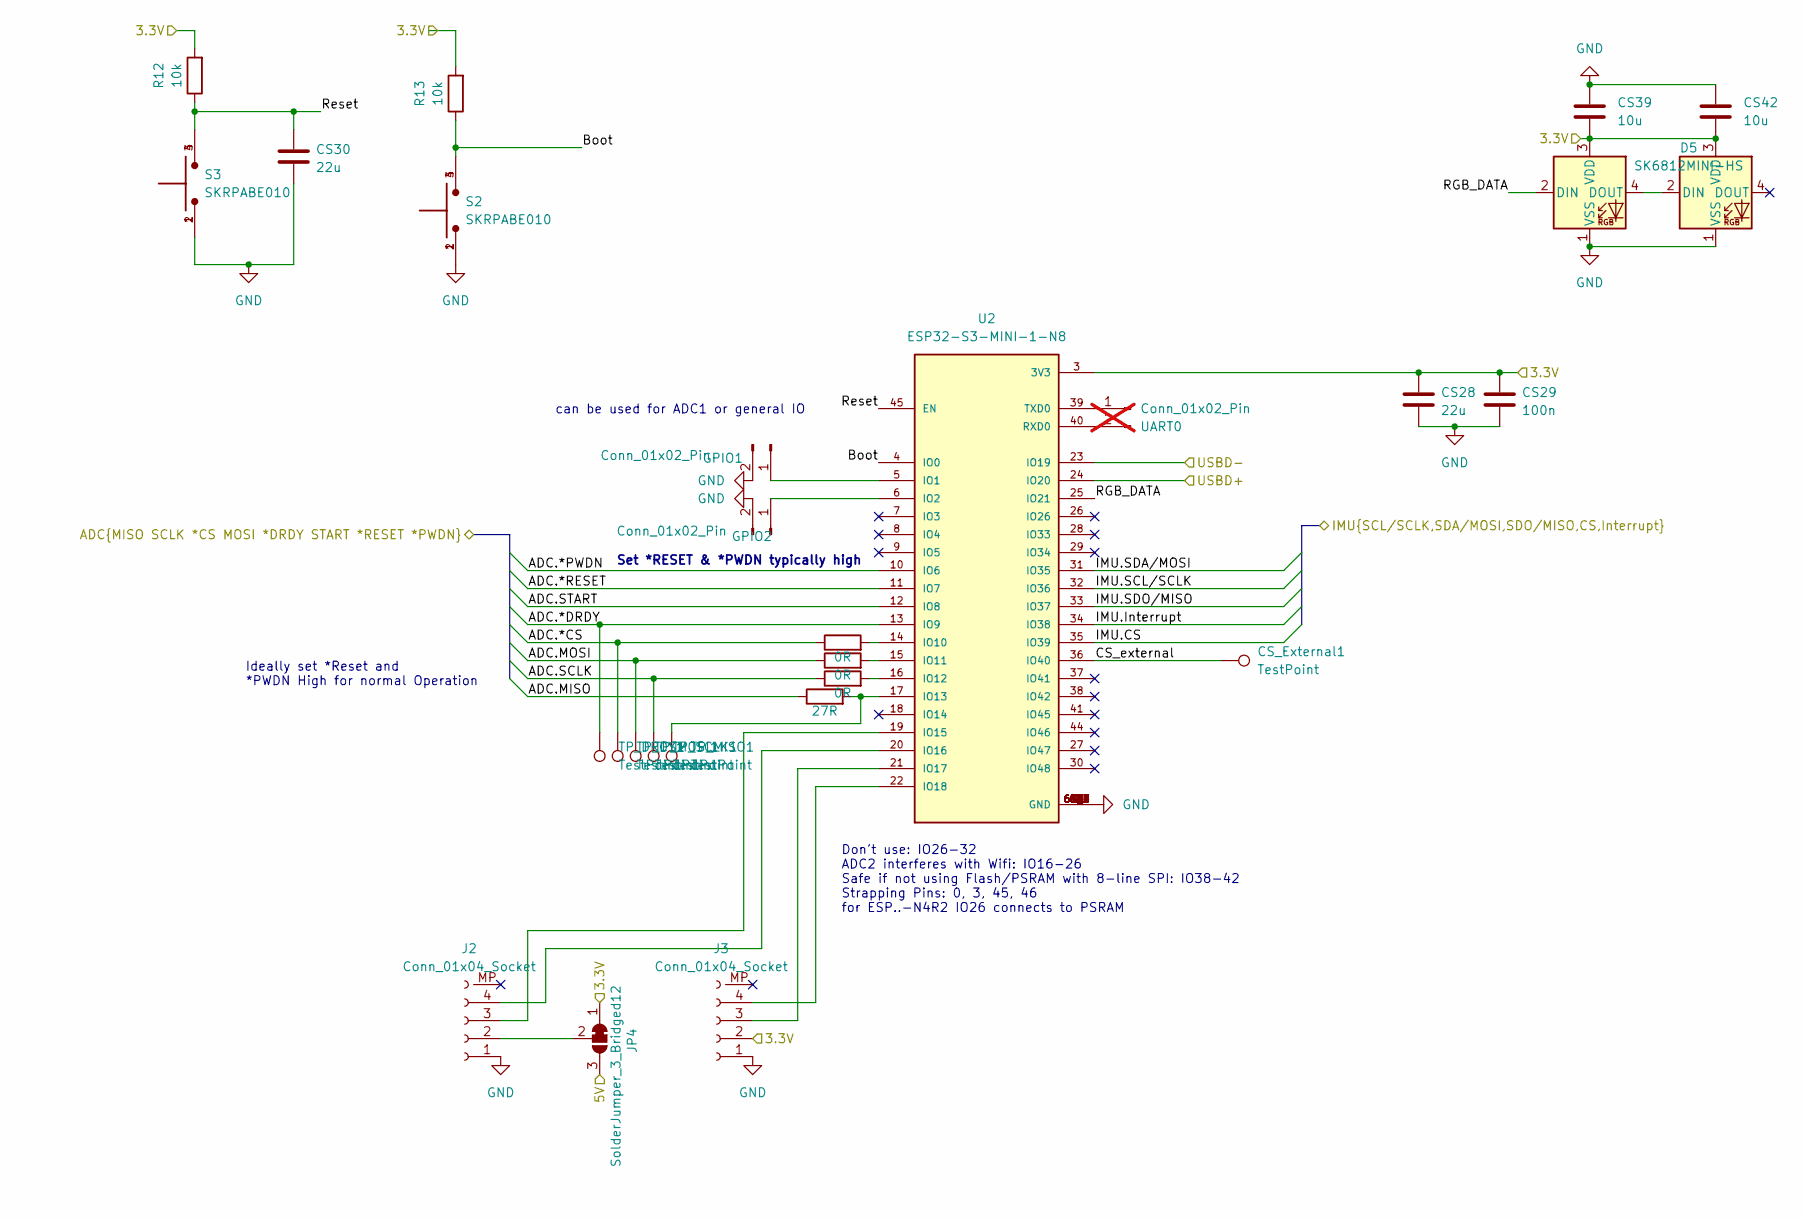
[picture p12: schematic ESP32.kicad_sch]

Parts:
CS28, CS30: 22u; C_0603_1608Metric; LCSC C59461
CS29: 100n; C_0603_1608Metric; LCSC C14663
CS39, CS42: 10u; C_0603_1608Metric; LCSC C19702
CS_External1: TestPoint; TestPoint_THTPad_D1.0mm_Drill0.5mm
D5, D6: SK6812MINI-HS; SK6812MNI-HS; LCSC C2922787
GPIO1, GPIO2: Conn_01x02_Pin; PinHeader_1x02_P2.54mm_Vertical; LCSC C492401
J2, J3: Conn_01x04_Socket; JST_SH_BM04B-SRSS-TB_1x04-1MP_P1.00mm_Vertical; LCSC C495539
JP4: SolderJumper_3_Bridged12; SolderJumper-3_P1.3mm_Bridged2Bar12_RoundedPad1.0x1.5mm
R12, R13: 10k; R_0603_1608Metric; LCSC C25804
R27: 27R; R_0603_1608Metric; LCSC C25190
R28, R29, R30: 0R; R_0603_1608Metric; LCSC C21189
S2, S3: SKRPABE010; SW_SKRPABE010; LCSC C115360
TP_CS1: TestPoint; TestPoint_Pad_D1.0mm
TP_DRDY1: TestPoint; TestPoint_Pad_D1.0mm
TP_MISO1: TestPoint; TestPoint_Pad_D1.0mm
TP_MOSI1: TestPoint; TestPoint_Pad_D1.0mm
TP_SCLK1: TestPoint; TestPoint_Pad_D1.0mm
U2: ESP32-S3-MINI-1-N8; XCVR_ESP32-S3-MINI-1-N8; PARTREV v0.6; LCSC C2913206
UART0: Conn_01x02_Pin; PinHeader_1x02_P1.27mm_Vertical; not fitted

Connections:
/ADC/ADC.*CS: R30.1, TP_CS1.1 (1_1); also elsewhere on the board
/ADC/ADC.*DRDY: TP_DRDY1.1 (1_1), U2.13 (IO9); also elsewhere on the board
/ADC/ADC.*PWDN: U2.10 (IO6); also elsewhere on the board
/ADC/ADC.*RESET: U2.11 (IO7); also elsewhere on the board
/ADC/ADC.MISO: R27.1; also elsewhere on the board
/ADC/ADC.MOSI: R28.1, TP_MOSI1.1 (1_1); also elsewhere on the board
/ADC/ADC.SCLK: R29.1, TP_SCLK1.1 (1_1); also elsewhere on the board
/ADC/ADC.START: U2.12 (IO8); also elsewhere on the board
/ADC/AVDD: JP4.3 (B); also elsewhere on the board
/ADC/DVDD: CS28.2, CS29.2, CS39.1, CS42.1, D5.3 (VDD), D6.3 (VDD), J3.2, JP4.1 (A), R12.2, R13.2, U2.3 (3V3); also elsewhere on the board
/ESP32/Boot: R13.1, S2.3, S2.4, U2.4 (IO0)
/ESP32/CS_external: CS_External1.1 (1_1), U2.36 (IO40)
/ESP32/IMU.CS: U2.35 (IO39); also elsewhere on the board
/ESP32/IMU.Interrupt: U2.34 (IO38); also elsewhere on the board
/ESP32/IMU.SCL/SCLK: U2.32 (IO36); also elsewhere on the board
/ESP32/IMU.SDA/MOSI: U2.31 (IO35); also elsewhere on the board
/ESP32/IMU.SDO/MISO: U2.33 (IO37); also elsewhere on the board
/ESP32/RGB_DATA: D5.2 (DIN), U2.25 (IO21)
/ESP32/Reset: CS30.2, R12.1, S3.3, S3.4, U2.45 (EN)
/USBD+: U2.24 (IO20); also elsewhere on the board
/USBD-: U2.23 (IO19); also elsewhere on the board
GND: CS28.1, CS29.1, CS30.1, CS39.2, CS42.2, D5.1 (VSS), D6.1 (VSS), GPIO1.2, GPIO2.2, J2.1, J3.1, S2.1, S2.2, S3.1, S3.2, U2.1 (GND), U2.2 (GND), U2.42 (GND), U2.43 (GND), U2.46 (GND), U2.47 (GND), U2.48 (GND), U2.49 (GND), U2.50 (GND), U2.51 (GND), U2.52 (GND), U2.53 (GND), U2.54 (GND), U2.55 (GND), U2.56 (GND), U2.57 (GND), U2.58 (GND), U2.59 (GND), U2.60 (GND), U2.61 (GND), U2.61_1 (GND), U2.61_2 (GND), U2.61_3 (GND), U2.61_4 (GND), U2.61_5 (GND), U2.61_6 (GND), U2.61_7 (GND), U2.61_8 (GND), U2.62 (GND), U2.63 (GND), U2.64 (GND), U2.65 (GND); also elsewhere on the board
unnamed: D5.4 (DOUT), D6.2 (DIN)
unnamed: GPIO1.1, U2.5 (IO1)
unnamed: GPIO2.1, U2.6 (IO2)
unnamed: J2.2, JP4.2 (C)
unnamed: J2.3, U2.19 (IO15)
unnamed: J3.3, U2.21 (IO17)
unnamed: R30.2, U2.14 (IO10)
unnamed: R28.2, U2.15 (IO11)
unnamed: R29.2, U2.16 (IO12)
unnamed: R27.2, TP_MISO1.1 (1_1), U2.17 (IO13)
unnamed: J2.4, U2.20 (IO16)
unnamed: J3.4, U2.22 (IO18)
unnamed: U2.40 (RXD0), UART0.2
unnamed: U2.39 (TXD0), UART0.1

Notes on the sheet:
Don't use: IO26-32 ADC2 interferes with Wifi: IO16-26 Safe if not using Flash/PSRAM with 8-line SPI: IO38-42 Strapping Pins: 0, 3, 45, 46 for ESP..-N4R2 IO26 connects to PSRAM
Set *RESET & *PWDN typically high
Ideally set *Reset and *PWDN High for normal Operation
can be used for ADC1 or general IO

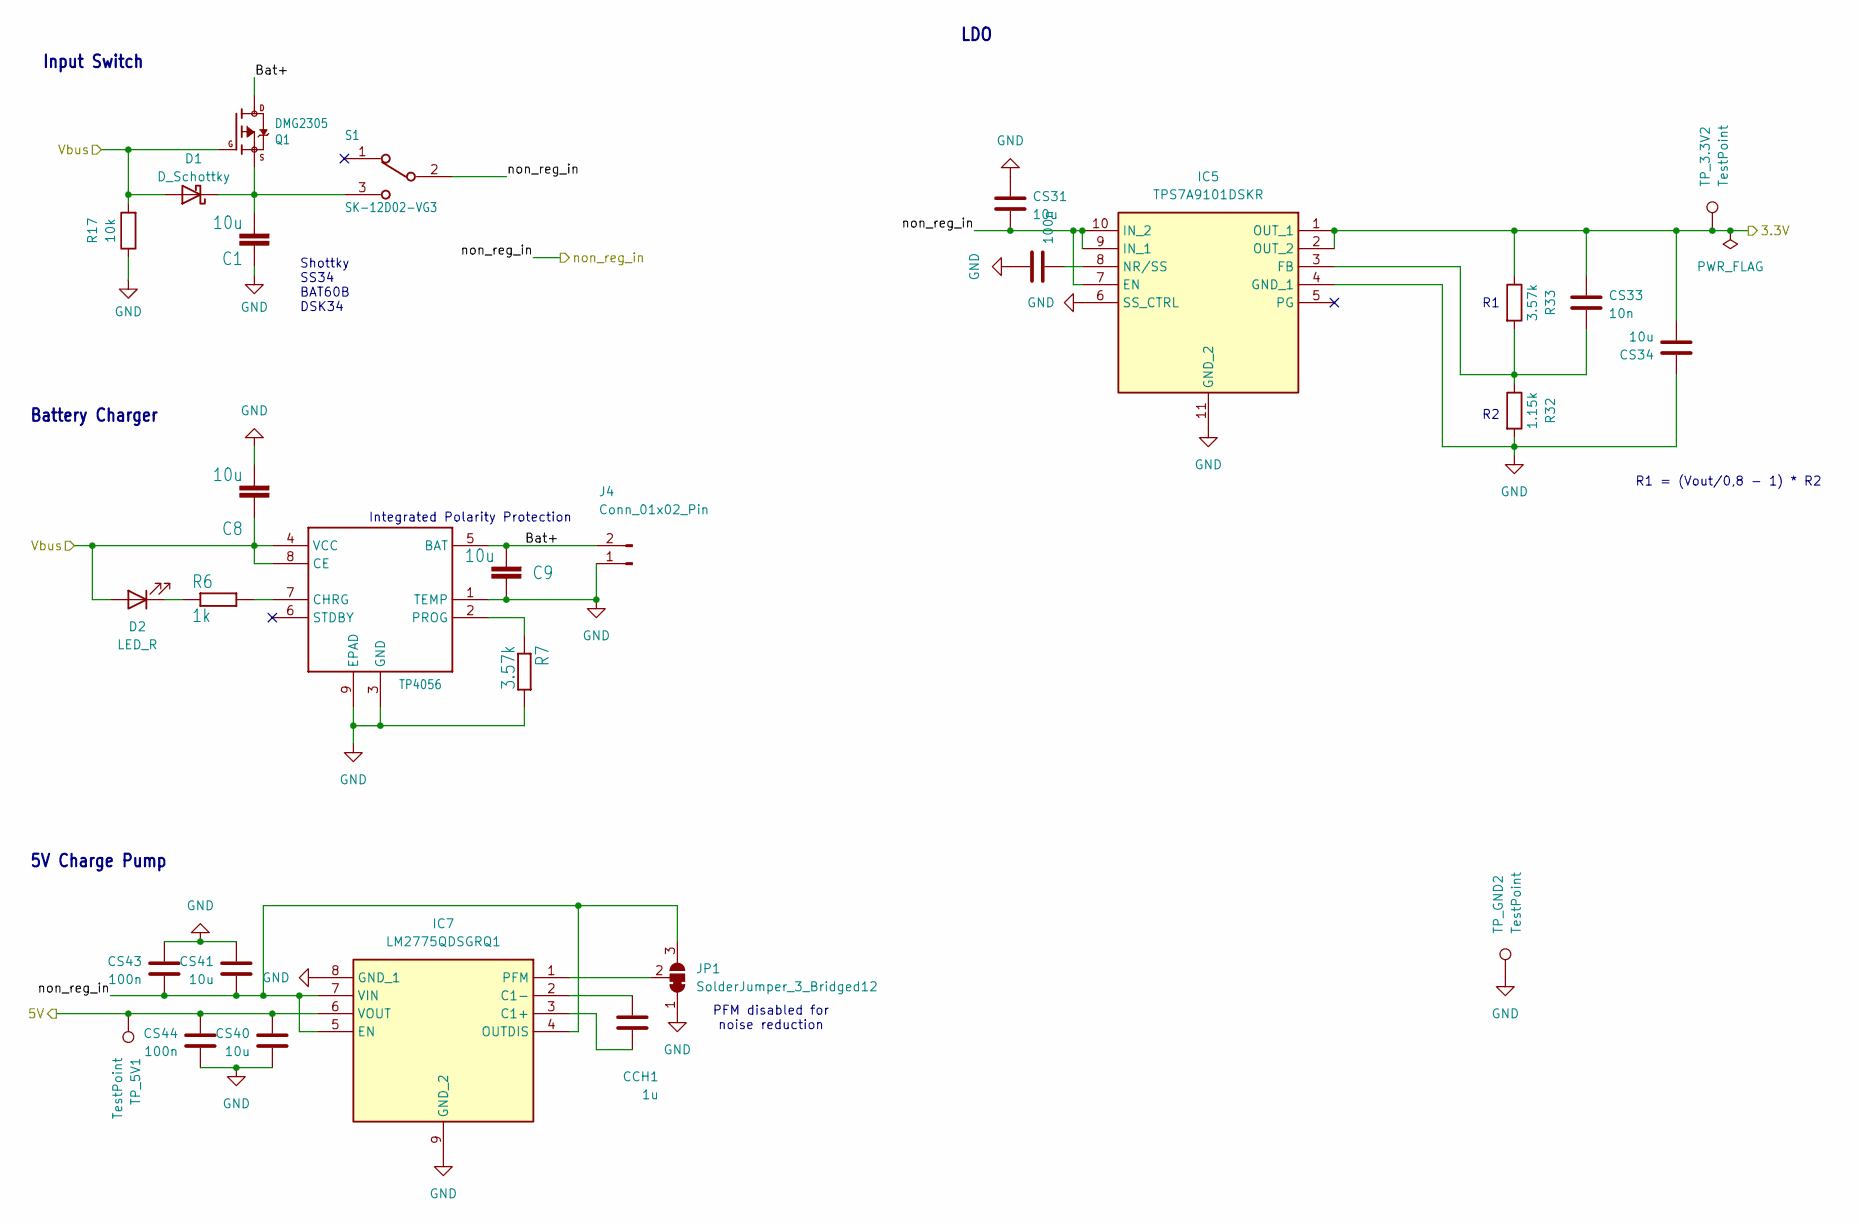
[picture p13: schematic Power.kicad_sch]

Parts:
C1, C8, C9: 10u; C_0603_1608Metric; LCSC C19702
CCH1: 1u; C_0603_1608Metric; LCSC C15849
CS31, CS34, CS40, CS41: 10u; C_0603_1608Metric; LCSC C19702
CS32, CS43, CS44: 100n; C_0603_1608Metric; LCSC C14663
CS33: 10n; C_0603_1608Metric; LCSC C57112
D1: D_Schottky; D_SOD-323; LCSC C7502695
D2: LED_R; LED_0603_1608Metric; LCSC C2286
IC2: TP4056; SOP127P600X175-9N; LCSC C2763448
IC5: TPS7A9101DSKR; SON50P250X250X80-11N-D; Mouser Part Number 595-TPS7A9101DSKR
IC7: LM2775QDSGRQ1; SON50P200X200X80-9N; Mouser Part Number 595-LM2775QDSGRQ1
J4: Conn_01x02_Pin; JST_PH_B2B-PH-K_1x02_P2.00mm_Vertical; LCSC C594142
JP1: SolderJumper_3_Bridged12; SolderJumper-3_P1.3mm_Bridged2Bar12_RoundedPad1.0x1.5mm
Q1: DMG2305; DMG2305UX; LCSC C2940629
R6: 1k; R_0603_1608Metric; LCSC C21190
R7, R33: 3.57k; R_0603_1608Metric; LCSC C326745
R17: 10k; R_0603_1608Metric; LCSC C25804
R32: 1.15k; R_0603_1608Metric; LCSC C861724
S1: SK-12D02-VG3; SK12D02VG3; LCSC C136723
TP_3.3V2, TP_5V1: TestPoint; TestPoint_Pad_D1.0mm
TP_GND2: TestPoint; TestPoint_Pad_D1.0mm

Connections:
/ADC/AVDD: CS40.2, CS44.2, IC7.6 (VOUT), TP_5V1.1 (1_1); also elsewhere on the board
/ADC/DVDD: CS33.2, CS34.1, IC5.1 (OUT_1), IC5.2 (OUT_2), R33.1, TP_3.3V2.1 (1_1); also elsewhere on the board
/Power_battery/Bat+: C9.2, IC2.5 (BAT), J4.2, Q1.3 (D)
/Power_battery/non_reg_in: CS31.1, CS41.1, CS43.1, IC5.7 (EN), IC5.9 (IN_1), IC5.10 (IN_2), IC7.4 (OUTDIS), IC7.5 (EN), IC7.7 (VIN), JP1.3 (B), S1.2; also elsewhere on the board
/Vbus: C8.1, D1.2 (A), D2.2 (A), IC2.4 (VCC), IC2.8 (CE), Q1.1 (G), R17.2; also elsewhere on the board
GND: C1.1, C8.2, C9.1, CS31.2, CS32.2, CS34.2, CS40.1, CS41.2, CS43.2, CS44.1, IC2.1 (TEMP), IC2.3 (GND), IC2.9 (EPAD), IC5.4 (GND_1), IC5.6 (SS_CTRL), IC5.11 (GND_2), IC7.8 (GND_1), IC7.9 (GND_2), J4.1, JP1.1 (A), R7.2, R17.1, R32.2, TP_GND2.1 (1_1); also elsewhere on the board
unnamed: C1.2, D1.1 (K), Q1.2 (S), S1.3
unnamed: D2.1 (K), R6.1
unnamed: IC2.7 (CHRG), R6.2
unnamed: IC2.2 (PROG), R7.1
unnamed: CS33.1, IC5.3 (FB), R32.1, R33.2
unnamed: CS32.1, IC5.8 (NR/SS)
unnamed: CCH1.1, IC7.3 (C1+)
unnamed: CCH1.2, IC7.2 (C1-)
unnamed: IC7.1 (PFM), JP1.2 (C)

Notes on the sheet:
R1 = (Vout/0,8 - 1) * R2
PFM disabled for noise reduction
Input Switch
Battery Charger
LDO
5V Charge Pump
Integrated Polarity Protection
Shottky SS34 BAT60B DSK34

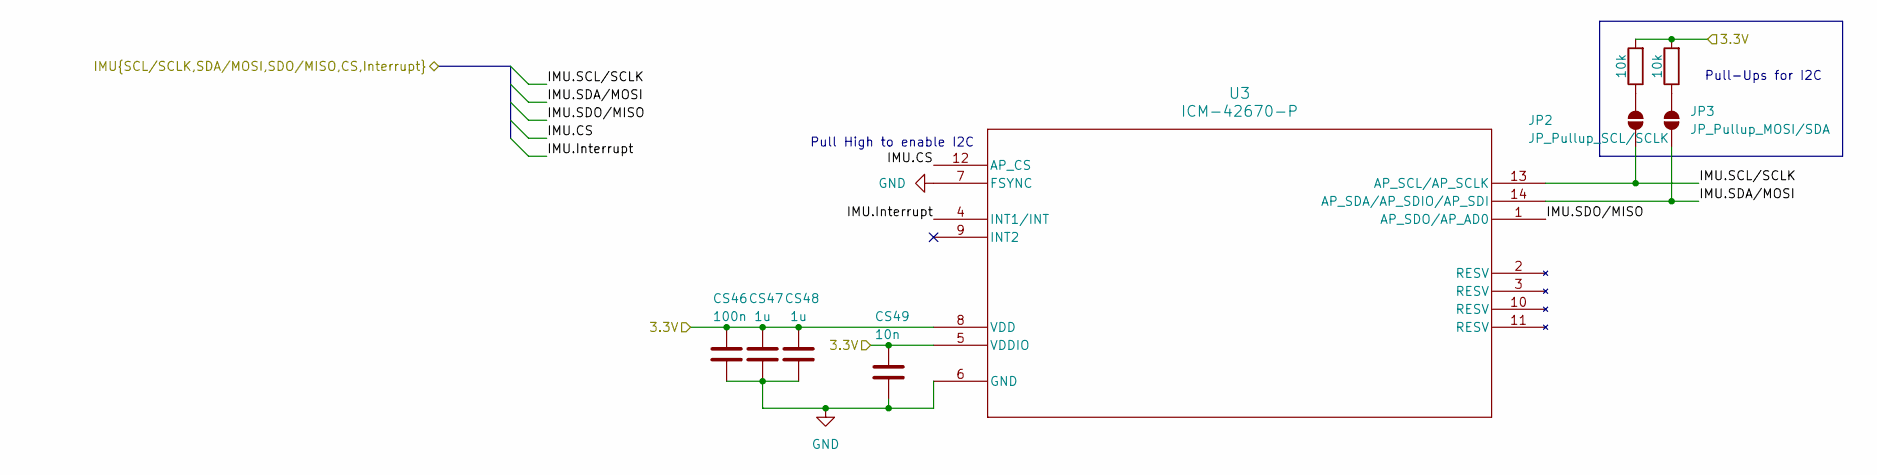
[picture p14: schematic IMU.kicad_sch]

Parts:
CS46: 100n; C_0603_1608Metric; LCSC C14663
CS47, CS48: 1u; C_0603_1608Metric; LCSC C15849
CS49: 10n; C_0603_1608Metric; LCSC C57112
JP2: JP_Pullup_SCL/SCLK; SolderJumper-2_P1.3mm_Open_RoundedPad1.0x1.5mm
JP3: JP_Pullup_MOSI/SDA; SolderJumper-2_P1.3mm_Open_RoundedPad1.0x1.5mm
R15, R16: 10k; R_0603_1608Metric; LCSC C25804
U3: ICM-42670-P; LGA14_2.5X3X0.76_IVS; LCSC C3288646

Connections:
/ADC/DVDD: CS46.2, CS47.1, CS48.1, CS49.2, R15.2, R16.2, U3.5 (VDDIO), U3.8 (VDD); also elsewhere on the board
/ESP32/IMU.CS: U3.12 (AP_CS); also elsewhere on the board
/ESP32/IMU.Interrupt: U3.4 (INT1/INT); also elsewhere on the board
/ESP32/IMU.SCL/SCLK: JP2.1 (A), U3.13 (AP_SCL/AP_SCLK); also elsewhere on the board
/ESP32/IMU.SDA/MOSI: JP3.1 (A), U3.14 (AP_SDA/AP_SDIO/AP_SDI); also elsewhere on the board
/ESP32/IMU.SDO/MISO: U3.1 (AP_SDO/AP_AD0); also elsewhere on the board
GND: CS46.1, CS47.2, CS48.2, CS49.1, U3.6 (GND), U3.7 (FSYNC); also elsewhere on the board
unnamed: JP2.2 (B), R15.1
unnamed: JP3.2 (B), R16.1

Notes on the sheet:
Pull-Ups for I2C
Pull High to enable I2C

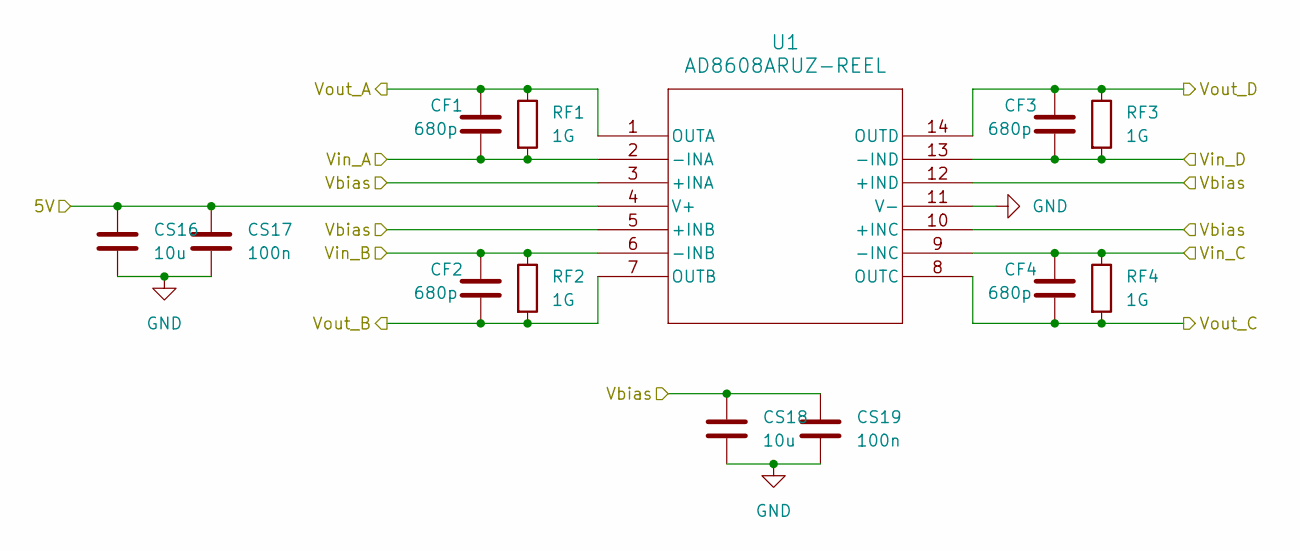
[picture p15: schematic Charge-Amplifier-Sensitive.kicad_sch]

Parts:
CF1, CF2, CF3, CF4: 680p; C_0805_2012Metric_Pad1.18x1.45mm_HandSolder; LCSC C1835
CS16, CS18: 10u; C_0603_1608Metric; LCSC C19702
CS17, CS19: 100n; C_0603_1608Metric; LCSC C14663
RF1, RF2, RF3, RF4: 1G; R_0805_2012Metric_Pad1.20x1.40mm_HandSolder; LCSC C2484710
U1: AD8608ARUZ-REEL; RU_14_ADI; LCSC C578777

Connections:
/ADC/AVDD: CS16.1, CS17.1, U1.4 (V+); also elsewhere on the board
/ADC/Charge-Amplifier-PORT I/Vin_A: CF1.2, RF1.2, U1.2 (-INA); also elsewhere on the board
/ADC/Charge-Amplifier-PORT I/Vin_B: CF2.1, RF2.1, U1.6 (-INB); also elsewhere on the board
/ADC/Charge-Amplifier-PORT I/Vin_C: CF4.1, RF4.1, U1.9 (-INC); also elsewhere on the board
/ADC/Charge-Amplifier-PORT I/Vin_D: CF3.2, RF3.2, U1.13 (-IND); also elsewhere on the board
/ADC/Charge-Amplifier-PORT I/Vout_A: CF1.1, RF1.1, U1.1 (OUTA); also elsewhere on the board
/ADC/Charge-Amplifier-PORT I/Vout_B: CF2.2, RF2.2, U1.7 (OUTB); also elsewhere on the board
/ADC/Charge-Amplifier-PORT I/Vout_C: CF4.2, RF4.2, U1.8 (OUTC); also elsewhere on the board
/ADC/Charge-Amplifier-PORT I/Vout_D: CF3.1, RF3.1, U1.14 (OUTD); also elsewhere on the board
/ADC/Vbias: CS18.1, CS19.1, U1.3 (+INA), U1.5 (+INB), U1.10 (+INC), U1.12 (+IND); also elsewhere on the board
GND: CS16.2, CS17.2, CS18.2, CS19.2, U1.11 (V-); also elsewhere on the board

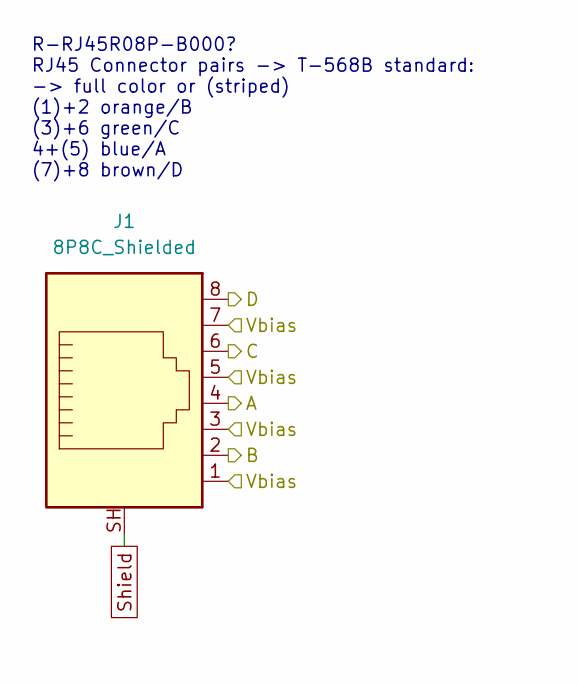
[picture p16: schematic RJ45.kicad_sch]

Parts:
J1: 8P8C_Shielded; R-RJ45R08P-B000; LCSC C386756

Connections:
/ADC/Charge-Amplifier-PORT I/Vin_A: J1.4; also elsewhere on the board
/ADC/Charge-Amplifier-PORT I/Vin_B: J1.2; also elsewhere on the board
/ADC/Charge-Amplifier-PORT I/Vin_C: J1.6; also elsewhere on the board
/ADC/Charge-Amplifier-PORT I/Vin_D: J1.8; also elsewhere on the board
/ADC/Vbias: J1.1, J1.3, J1.5, J1.7; also elsewhere on the board
Shield: J1.SH; also elsewhere on the board

Parts of its further copies:
J5: 8P8C_Shielded; R-RJ45R08P-B000; LCSC C386756

Connections of its further copies:
/ADC/Charge-Amplifier-PORT II/Vin_A: J5.4; also elsewhere on the board
/ADC/Charge-Amplifier-PORT II/Vin_B: J5.2; also elsewhere on the board
/ADC/Charge-Amplifier-PORT II/Vin_C: J5.6; also elsewhere on the board
/ADC/Charge-Amplifier-PORT II/Vin_D: J5.8; also elsewhere on the board
/ADC/Vbias: J5.1, J5.3, J5.5, J5.7; also elsewhere on the board
Shield: J5.SH; also elsewhere on the board

Notes on the sheet:
R-RJ45R08P-B000? RJ45 Connector pairs -> T-568B standard: -> full color or (striped) (1)+2 orange/B (3)+6 green/C 4+(5) blue/A (7)+8 brown/D

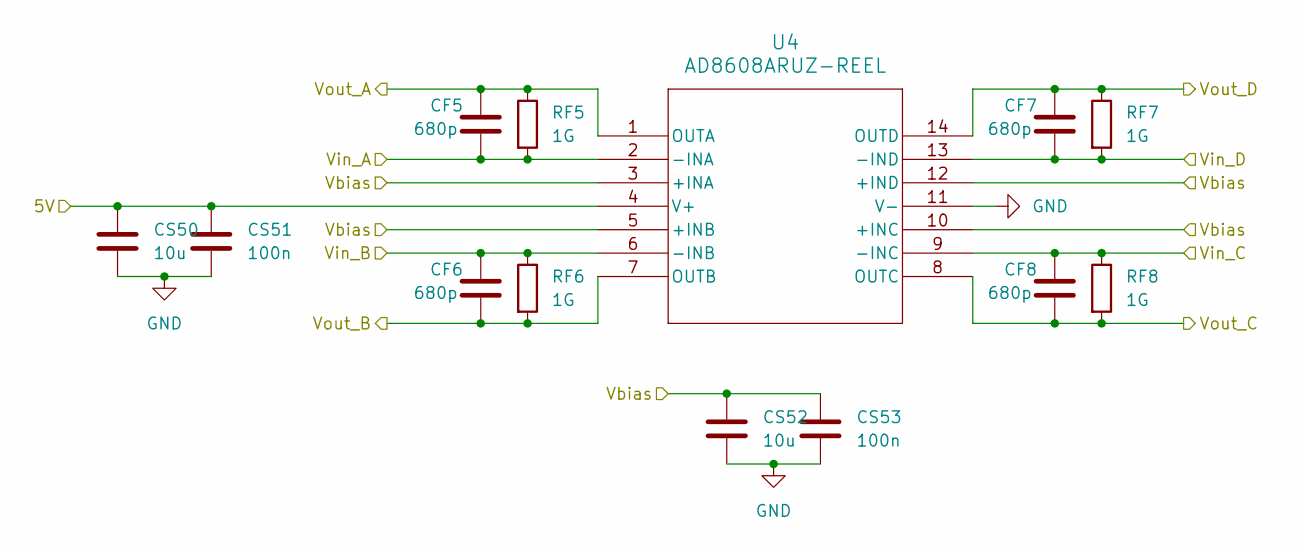
[picture p17: schematic Charge-Amplifier.kicad_sch]

Parts:
CF5, CF6, CF7, CF8: 680p; C_0805_2012Metric_Pad1.18x1.45mm_HandSolder; LCSC C1835
CS50, CS52: 10u; C_0603_1608Metric; LCSC C19702
CS51, CS53: 100n; C_0603_1608Metric; LCSC C14663
RF5, RF6, RF7, RF8: 1G; R_0805_2012Metric_Pad1.20x1.40mm_HandSolder; LCSC C2484710
U4: AD8608ARUZ-REEL; RU_14_ADI; LCSC C578777

Connections:
/ADC/AVDD: CS50.1, CS51.1, U4.4 (V+); also elsewhere on the board
/ADC/Charge-Amplifier-PORT II/Vin_A: CF5.2, RF5.2, U4.2 (-INA); also elsewhere on the board
/ADC/Charge-Amplifier-PORT II/Vin_B: CF6.1, RF6.1, U4.6 (-INB); also elsewhere on the board
/ADC/Charge-Amplifier-PORT II/Vin_C: CF8.1, RF8.1, U4.9 (-INC); also elsewhere on the board
/ADC/Charge-Amplifier-PORT II/Vin_D: CF7.2, RF7.2, U4.13 (-IND); also elsewhere on the board
/ADC/Charge-Amplifier-PORT II/Vout_A: CF5.1, RF5.1, U4.1 (OUTA); also elsewhere on the board
/ADC/Charge-Amplifier-PORT II/Vout_B: CF6.2, RF6.2, U4.7 (OUTB); also elsewhere on the board
/ADC/Charge-Amplifier-PORT II/Vout_C: CF8.2, RF8.2, U4.8 (OUTC); also elsewhere on the board
/ADC/Charge-Amplifier-PORT II/Vout_D: CF7.1, RF7.1, U4.14 (OUTD); also elsewhere on the board
/ADC/Vbias: CS52.1, CS53.1, U4.3 (+INA), U4.5 (+INB), U4.10 (+INC), U4.12 (+IND); also elsewhere on the board
GND: CS50.2, CS51.2, CS52.2, CS53.2, U4.11 (V-); also elsewhere on the board
