TUDA-MUST/Multi-Ferro-DAQ/PCB/Multi-Ferro-DAQ.kicad_pcb

## KiCad design PCB/Multi-Ferro-DAQ.kicad_pcb (continued)

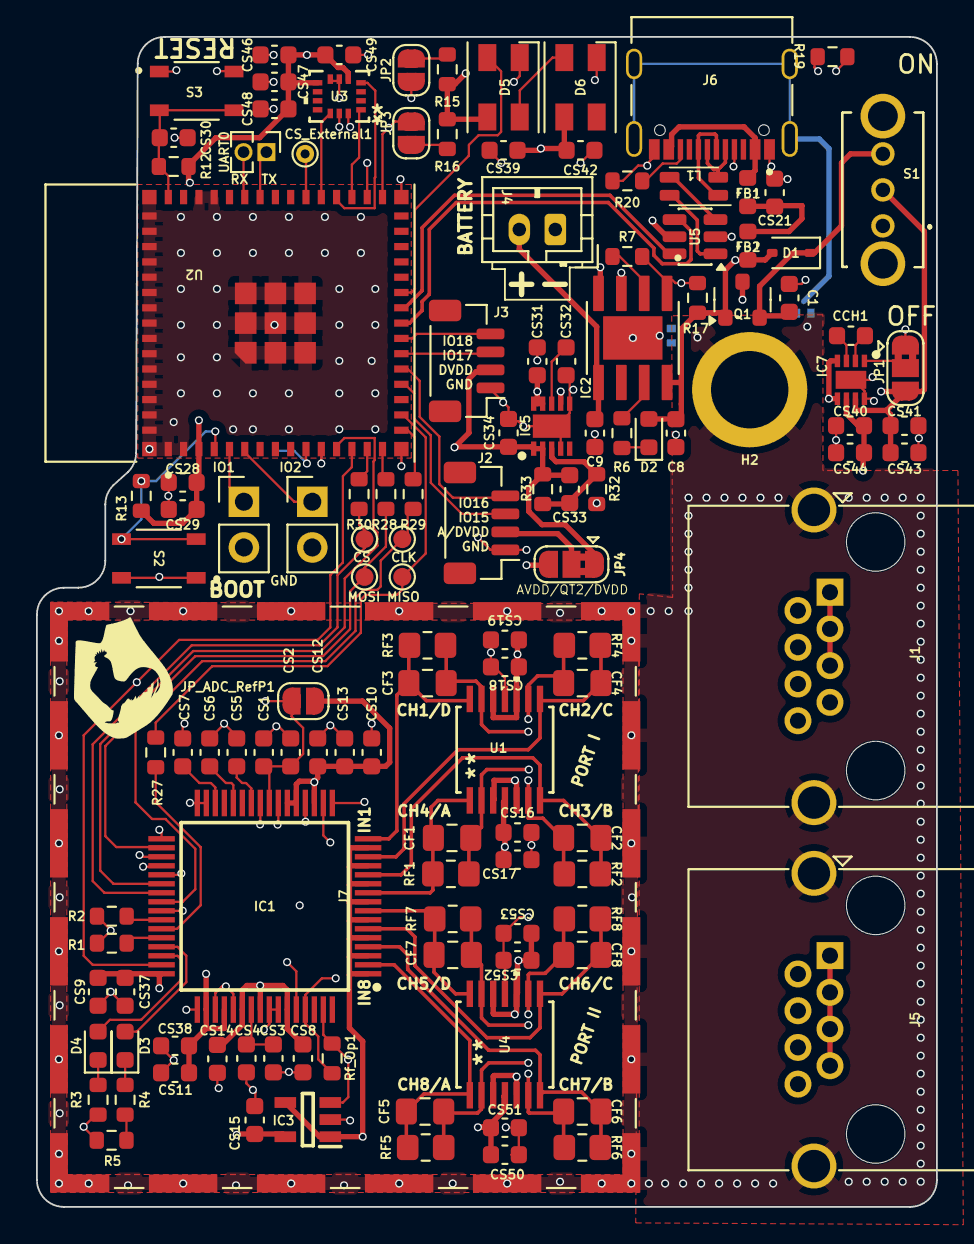
[picture p18: board Multi-Ferro-DAQ.kicad_pcb from above]

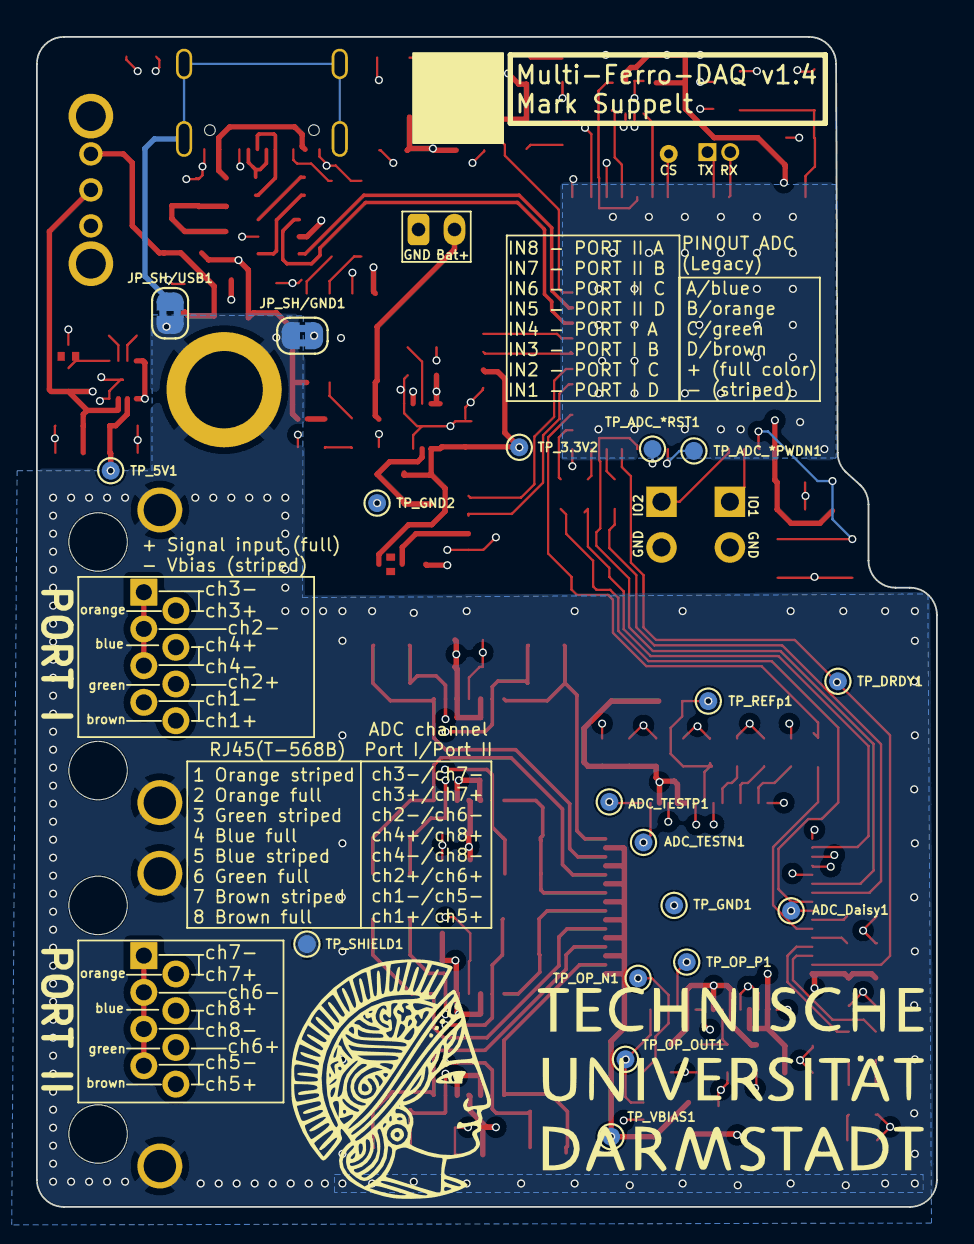
[picture p19: board Multi-Ferro-DAQ.kicad_pcb from below]

Board: 4 copper layers, 50.0 x 65.0 mm, 146 parts (18 on the bottom side), 95 nets.
