TUDA-MUST/Multi-Ferro-DAQ/(commit log)

2024-10-09 finished SPI, working on ADC
2024-10-23 added IMU
2024-11-26 added a first blink for the SchlaubiSchlumpf board
    example uses the FastLED library
2024-11-26 added datasheet for LEDs
2024-11-26 added a first example to utilize the IMU via SPI
2024-11-26 Update README.md to include calibration notice
2024-12-06 Added files for ADC test and libs
2024-12-06 Create ADC folder
2024-12-09 updated adc_test
    .h are and .cpp driver files are converted but have not recieved testing as of yet.
    Problems may arise @ ADS131E08_wait_drdy_int as this funciton is handled by
    interrupts on the STM32.
2024-12-17 made progress with debugging
    The esp32 is now runnable and reaches the loop(). Although we send data to dhe ADC
    we don't recieve any at the moment.
2024-12-17 Delete ADC/ardu_adc_test/lib/spi_multiple_buses.c
    file deprecated
2024-12-17 Delete ADC/ardu_adc_test/lib/spi_multiple_buses.h
    filed deprecated
2025-01-17 working dual core on 4kSPS + Serial.print()
2025-01-20 chars work @1kSPS, but crashes after 4674/4675 print cycles
2025-02-10 commendted out debug prints
2025-03-13 Added TCP for Arduino
2025-03-17 sending sample count to esp
2025-10-14 corrected cap/resistor
2025-10-30 Update README.md
    forgot to mention ESP32 IP Adress
2025-12-01 made hotspot credentials configureable on ESP32
2026-03-17 Revise README for ADC WiFi readout and MMM usage
    Updated references to MATLAB script and MMM firmware.
2026-08-27 cutout antenna + saved rotation
2026-10-27 relinked components for KiCAD 9.0
2026-11-03 migrated to kicad 10
2026-11-05 updated silkscreen
2026-11-12 v1.4v Release candidate
